LSRHokie/DIY-Flow-Bench/README.md

# NOTE: (Further information to be filled out later)   Project used knowledge and experience gained from Dee-Emm's DIY-Flow-Bench.    Project being developed for personal use with significant enough differences that i removed the fork from the original project.

[Link to the orignal DeeEmm project:](https://github.com/DeeEmm/DIY-Flow-Bench/)
