LSRHokie/DIY-Flow-Bench/hardware/kicad/flowbench-main/placement-preview.png

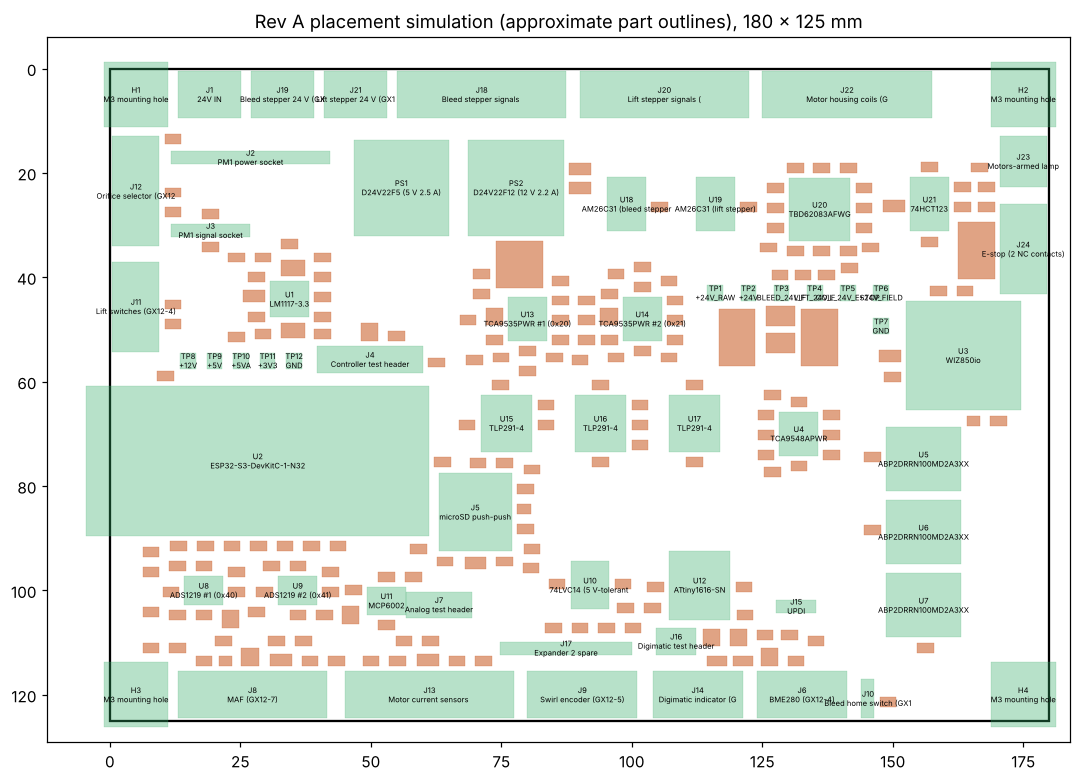
hardware/kicad/flowbench-main/placement-preview.png
