LSRHokie/DIY-Flow-Bench/docs/V2/bom.csv

Group | Qty | Part | Ref | What it does | Package | Status
Controller and network | 1 | ESP32-S3-DevKitC-1-N32R8V | U1 | Controller. 32 MB octal flash, 8 MB PSRAM, on-board antenna. Plugs into female headers. The current N32R16V (16 MB PSRAM) is a drop-in alternative. | Dev board | Decided
Controller and network | 2 | 2 × 22-pin female header, 2.54 mm | U1 | Sockets for the DevKit, rows 25.4 mm (1.0 in) apart (footprint FlowBench:ESP32-S3-DevKitC-1). | Through-hole | Decided
Controller and network | 1 | WIZnet WIZ850io | U2 | W5500 Ethernet module with RJ45 jack and magnetics on board. Alone on the SPI bus, polled (its interrupt can be jumpered to expander 2 P06). Primary network link; Wi-Fi is the fallback. Plugs in, so it moves to a new board revision. | Module | Decided
Controller and network | 2 | 1 × 6-pin female header, 2.54 mm | U2 | Sockets for the WIZ850io J1 and J2, rows 17.78 mm (0.7 in) apart (footprint FlowBench:WIZ850io). | Through-hole | Decided
Controller and network | 1 | Push-push microSD socket | J2 | Test logs and calibration files. On its own SD host bus in 1-bit mode (CLK, CMD, DAT0), not shared with the W5500. Card detect on expander 1. Pull-ups on CMD and DAT0–DAT3, 33 Ω on CLK. | SMD | Decided
Power | 1 | TI TPS26631PWP | PM1-U1 | Input eFuse on the plug-in power module: OVP 31.8 V, current limit 6.0 A, latch-off (jumper for auto-retry), inrush limit. Reverse polarity blocked by external FETs PM1-Q1/Q2. Fault and current-monitor outputs to the main board. Protects against the 48 V supply on the same XT90. | HTSSOP-20, thermal pad | Decided
Power | 1 | N-MOSFET, >=80 V, DPAK | PM1-Q1 | Reverse-polarity blocking FET driven by the eFuse B_GATE pin. Rds(on) <= 15 mOhm at 10 V (TI example CSD19537Q3). | TO-252 | Decided
Power | 1 | BSS138 | PM1-Q2 | Pulls the blocking FET gate down during reverse polarity (eFuse DRV pin). | SOT-23 | Decided
Power | 1 | Input power module (plug-in board) | PM1 | Small board carrying the TPS2663 eFuse, input TVS, bulk capacitors and the TPS7A4901 analog regulator, so the two thermal-pad parts can be replaced or moved to a new main board. Plugs in on 2.54 mm headers: 24 V in, protected 24 V out and ground on 4 pins each (about 3 A per pin); 12 V in, analog 5 V out, analog ground and eFuse fault on single pins. Made in the same PCB order. | Plug-in PCB | Decided
Power | 1 | SMCJ51CA TVS | PM1-D1 | Bidirectional input clamp ahead of the eFuse. 51 V stand-off, so a 48 V supply plugged in by mistake leaves it off and the eFuse OVP disconnects the board. | SMC | Decided
Power | 2 | Header pair for the power module | PM1 | Male headers on the module, female on the main board. Pin count set at schematic. | Through-hole | Decided
Power | 1 | Pololu D24V22F5 | PS1 | 5 V, 2.5 A switching regulator for the DevKit and logic. | Through-hole module | Decided
Power | 1 | Pololu D24V22F12 | PS2 | 12 V, 2.2 A switching regulator for the MAF and the analog rail. | Through-hole module | Decided
Power | 1 | TI TPS7A4901 | PM1-U2 | Low-noise analog 5 V from the 12 V rail, on the plug-in power module: ADC reference, MAF 5 V reference, temperature bias, harness ID. | MSOP-8, thermal pad | Decided
Power | 1 | TI LM1117-3.3 | U5 | 3.3 V, 1 A for the WIZ850io (about 130 mA), sensors, logic and Digimatic interface. | SOT-223 | Decided
Power | 3 | High-side 24 V switch (P-MOSFET + driver) | Q1–Q3 | Firmware-switched 24 V for each iCL42 (fault reset), and the watchdog-gated coil supply. Part chosen at schematic. | SMD | Decided
Power | 2 | Resettable fuse (PTC) | F1–F2 | Per-stepper 24 V protection. Rating set at schematic. | SMD | Decided
Sensing and measurement | 3 | Honeywell ABP2DRRN100MD2A3XX | U6–U8 | Pressure sensors for reference, orifice and pitot. ±100 mbar (±40 inH2O), I2C 0x28, 3.3 V, dual radial barbed ports. Confirm the overpressure rating and stock. | DIP | Decided
Sensing and measurement | 2 | TI ADS1219 | U9–U10 | 24-bit ADCs. #1 (0x40): MAF signal, intake air temperature, 5 V and 24 V checks. #2 (0x41, main bus): MAF harness ID, input current from the eFuse, two spare inputs. | TSSOP-16 | Decided
Sensing and measurement | 1 | TI TCA9548A | U11 | I2C multiplexer: three ABP2 sensors, the BME280 cable and ADC #2 each on their own channel. | TSSOP-24 | Decided
Sensing and measurement | 1 | Microchip ATtiny1616 | U12 | Digimatic interface: reads the lift indicator and answers on I2C 0x30. Firmware in firmware/digimatic-interface (capture method from KK4HFJ/mitutoyo-arduino). Programmed through a UPDI header. | SOIC-20 | Decided
Sensing and measurement | 1 | Microchip MCP6002 | U13 | Buffers the 1.65 V bias for the six motor-current inputs. | SOIC-8 | Decided
Sensing and measurement | 1 | 74LVC14 | U14 | Schmitt-trigger buffers for MAF frequency and the swirl encoder. | SOIC-14 | Decided
Sensing and measurement | — | Input protection | D1… | Series resistor plus BAV99-class clamps or TVS on every field input. Count set at schematic. | SOT-23 | Decided
I/O, drivers and safety logic | 2 | TI TCA9535 | U15–U16 | I/O expanders (0x20, 0x21): contactor coils, stepper enable and power, stepper alarms, switch inputs, eFuse fault. 8 spare pins on #2. | TSSOP-24 | Decided
I/O, drivers and safety logic | 2 | TI AM26C31 | U17–U18 | Differential line drivers for step, direction and enable to each iCL42-08. | SOIC-16 | Decided
I/O, drivers and safety logic | 1 | Toshiba TBD62083AFWG | U19 | 8-channel sink driver: six contactor coils, motors-armed lamp, one spare. | SOP-18 | Decided
I/O, drivers and safety logic | 3 | Toshiba TLP291-4 | U20–U22 | Optocouplers, 12 channels: E-stop status, both stepper alarms (iCL42-08 alarm is a normally open collector; opto LED fed from 5 V through 470 Ω), bleed home, lift home and max travel, three orifice bits, spares. | SOP-16 | Decided
I/O, drivers and safety logic | 1 | 74HCT123 | U23 | Hardware heartbeat watchdog, 5 V with TTL inputs so the 3.3 V heartbeat triggers it reliably. Drops the coil supply about 0.2 s after the firmware stops pulsing (220 k, 2.2 uF). | SOIC-16 | Decided
I/O, drivers and safety logic | 1 | UPDI programming header | J3 | For the ATtiny1616. | Through-hole | Decided
I/O, drivers and safety logic | — | Optional Digimatic inverter stage | Q10–Q11 | Footprints for an NPN transistor and resistors on the indicator's CLK and DATA lines. Fitted only if the bench check shows the signals need level shifting; otherwise bridged. | SOT-23 | Decided
I/O, drivers and safety logic | 3 | Solder jumpers | JP1–JP3 | JP1 microSD DAT0 to GPIO3 (cut if it upsets boot). JP2 MAF frequency 5 V pull-up (open-collector MAFs). JP3 WIZ850io INT to expander 2 P06. | SMD pad | Decided
I/O, drivers and safety logic | — | Test points | TP1… | Power rails, I2C, SPI, SD bus and Digimatic lines. | Through-hole loop | Decided
Panel connectors and controls | 1 | XT90 panel-mount connector |  | 24 V input from the workbench supply. | Panel | Decided
Panel connectors and controls | 1 | TE Potter & Brumfield W28-XQ1A-7 |  | 7 A, 32 V DC push-to-reset breaker. Check the tripped button is easy to see; Jaycar SF2297 is the fallback. | Panel | Decided
Panel connectors and controls | 1 | RJ45 panel bulkhead |  | Ethernet through the enclosure wall. | Panel | Decided
Panel connectors and controls | 1 | E-stop, mushroom head, 2 NC contacts |  | One contact carries the coil supply, the other reports status. | Panel | Decided
Panel connectors and controls | 1 | 24 V indicator lamp |  | Motors armed. | Panel | Decided
Panel connectors and controls | 1 | GX12 7-pin |  | MAF: 12 V, ground, analog signal (0–5 V), frequency signal, intake air temperature, 5 V reference, harness ID. Separate analog and frequency pins; the harness uses the one that matches the MAF. | Panel + plug | Decided
Panel connectors and controls | 3 | GX12 4-pin |  | BME280; lift indicator (Digimatic); lift actuator home and max-travel switches. | Panel + plug | Decided
Panel connectors and controls | 2 | GX12 5-pin |  | Swirl encoder; orifice selector. | Panel + plug | Decided
Panel connectors and controls | 1 | GX12 3-pin |  | Bleed valve home switch. | Panel + plug | Decided
Panel connectors and controls | 2 | GX12 2-pin |  | Switched 24 V to each iCL42-08. | Panel + plug | Decided
Panel connectors and controls | 4 | GX16 8-pin |  | Bleed and lift stepper signals (shielded); motor housing coils; motor current sensors (shielded). Buy plugs and sockets from one source. | Panel + plug | Decided
Panel connectors and controls | 6 | Barbed bulkhead fittings |  | Pressure ports: reference, orifice ±, pitot total and static, to the ABP2 ports by silicone tube. | Panel | Decided
Panel connectors and controls | 1 | Plastic or polycarbonate enclosure |  | Non-metal so the on-board Wi-Fi antenna works. Size set after PCB layout. |  | Decided
Panel connectors and controls | — | Pluggable terminal blocks |  | Board-side landing for every panel connector. Count set at schematic. | Through-hole | Decided
Field devices | 1 | Bosch 0280218335 (HFM-7-R5) |  | First MAF. Analog output, about 0–5 V. Confirm pinout and 12 V current on the prototype. Harness ID resistor 1.0 kΩ. |  | Decided
Field devices | 1 | SparkFun BME280 (Qwiic) |  | Temperature, humidity and baro at the enclosure air inlet, cable under about 1 m. | Breakout | Decided
Field devices | 2 | StepperOnline iCL42-08 |  | Integrated closed-loop NEMA 17 steppers, 0.8 Nm, 24 V: one for the bleed valve, one for valve lift. DIP SW6 off (closed loop). |  | Decided
Field devices | 1 | T8 lead screw kit, 8 mm lead |  | Lift actuator: lead screw, anti-backlash nut, 5 × 8 mm flexible coupler, support bearing, small linear rail and carriage. |  | Decided
Field devices | 1 | Mitutoyo 575-123 ID-U Digimatic indicator |  | Valve lift, 0–1 in, 0.0005 in resolution, ±0.0008 in. Any Digimatic-output indicator also works (Mahr MarCator 1086, Fowler/Sylvac Mark VI) with its maker's cable. |  | Decided
Field devices | 1 | Mitutoyo SPC cable 905338 (40 in) or 905409 (2 m) |  | Indicator data cable, plus a short adapter from its 10-pin plug to the GX12 4-pin. |  | Decided
Field devices | 3 | Limit switches |  | Bleed valve home, lift actuator home, lift actuator max travel. |  | Decided
Field devices | 1 | Bleed valve mechanism |  | Valve driven by the bleed iCL42-08. Designed with the bench plumbing. |  | Later
Field devices | 1 | Paddle-wheel swirl meter with quadrature encoder |  | Swirl speed and direction. |  | Later
Field devices | — | Calibrated orifice plates |  | Sourced later as known calibrated plates; selected by the 3-bit orifice selector. |  | Later
Field devices | 1 | Waveshare 12 in+ touch monitor and Raspberry Pi |  | Touch display showing the bench web page full-screen. Model being chosen. |  | Later
Vacuum motor housing (240 V) | 6 | Ametek Lamb 122165-00 |  | 240 V single-stage bypass vacuum motors, about 145 CFM each at a 28 inH2O test, up to 7.8 A each. |  | Decided
Vacuum motor housing (240 V) | 6 | Schneider TeSys D LC1D18BD |  | DIN-rail contactors, 18 A, 24 V DC coil (about 0.23 A) with built-in suppression. One per motor. | DIN rail | Decided
Vacuum motor housing (240 V) | 6 | YHDC SCT-013-010 |  | Clip-on current transformers, 10 A to 1 V. One on each motor's supply lead. |  | Decided
Vacuum motor housing (240 V) | 1 | 60 A, 240 V NEMA inlet and cord |  | Single supply connection for the housing. Your electrician chooses the exact parts. |  | Decided
Vacuum motor housing (240 V) | 6 | Per-motor branch protection |  | Breaker or fuse for each motor circuit, sized by your electrician. | DIN rail | Decided
Vacuum motor housing (240 V) | 1 | Main disconnect |  | Isolates the whole housing for service. |  | Decided
