LSRHokie/DIY-Flow-Bench/hardware/kicad/flowbench-main/controller.kicad_sch

## KiCad design hardware/kicad/flowbench-main/controller.kicad_sch (2026-10-29)

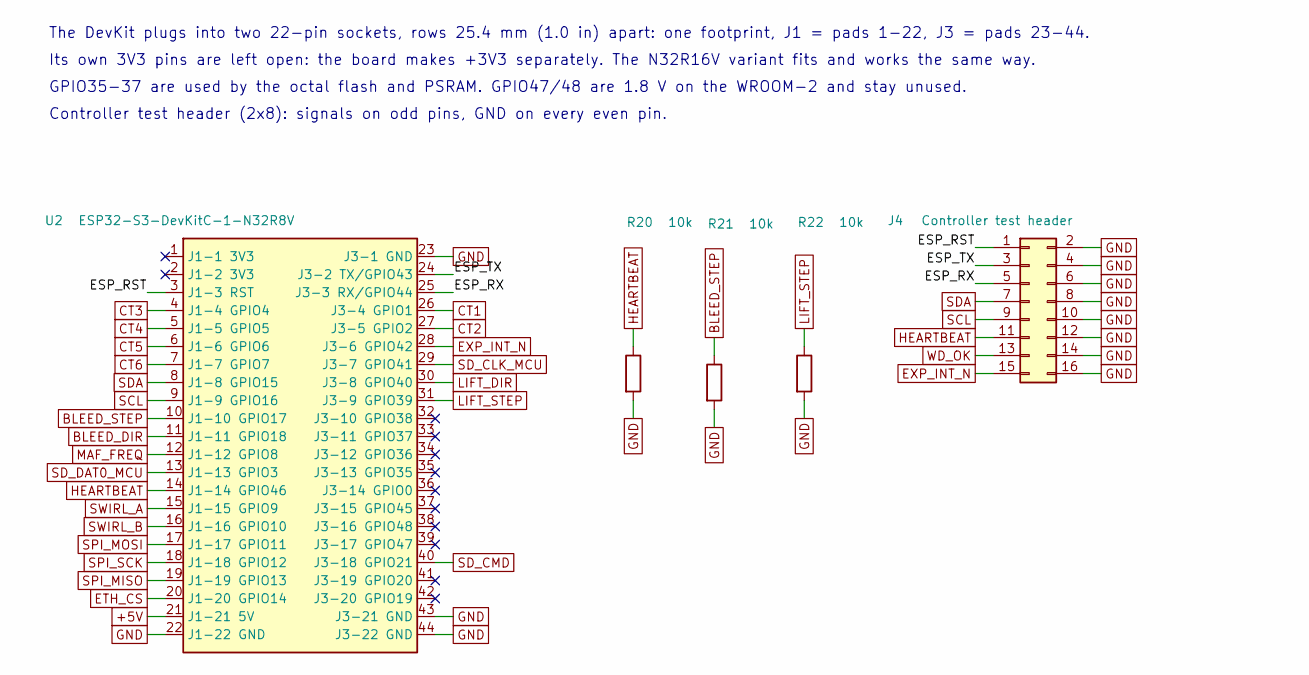
[picture p2: schematic controller.kicad_sch]

Parts:
J4: Controller test header; PinHeader_2x08_P2.54mm_Vertical
R20, R21, R22: 10k; R_0805_2012Metric
U2: ESP32-S3-DevKitC-1-N32R8V; ESP32-S3-DevKitC-1

Connections:
+5V: U2.21 (J1-21 5V)
BLEED_DIR: U2.11 (J1-11 GPIO18)
BLEED_STEP: R21.1, U2.10 (J1-10 GPIO17)
CT1: U2.26 (J3-4 GPIO1)
CT2: U2.27 (J3-5 GPIO2)
CT3: U2.4 (J1-4 GPIO4)
CT4: U2.5 (J1-5 GPIO5)
CT5: U2.6 (J1-6 GPIO6)
CT6: U2.7 (J1-7 GPIO7)
ESP_RST: J4.1, U2.3 (J1-3 RST)
ESP_RX: J4.5, U2.25 (J3-3 RX/GPIO44)
ESP_TX: J4.3, U2.24 (J3-2 TX/GPIO43)
ETH_CS: U2.20 (J1-20 GPIO14)
EXP_INT_N: J4.15, U2.28 (J3-6 GPIO42)
GND: J4.2, J4.4, J4.6, J4.8, J4.10, J4.12, J4.14, J4.16, R20.2, R21.2, R22.2, U2.22 (J1-22 GND), U2.23 (J3-1 GND), U2.43 (J3-21 GND), U2.44 (J3-22 GND)
HEARTBEAT: J4.11, R20.1, U2.14 (J1-14 GPIO46)
LIFT_DIR: U2.30 (J3-8 GPIO40)
LIFT_STEP: R22.1, U2.31 (J3-9 GPIO39)
MAF_FREQ: U2.12 (J1-12 GPIO8)
SCL: J4.9, U2.9 (J1-9 GPIO16)
SDA: J4.7, U2.8 (J1-8 GPIO15)
SD_CLK_MCU: U2.29 (J3-7 GPIO41)
SD_CMD: U2.40 (J3-18 GPIO21)
SD_DAT0_MCU: U2.13 (J1-13 GPIO3)
SPI_MISO: U2.19 (J1-19 GPIO13)
SPI_MOSI: U2.17 (J1-17 GPIO11)
SPI_SCK: U2.18 (J1-18 GPIO12)
SWIRL_A: U2.15 (J1-15 GPIO9)
SWIRL_B: U2.16 (J1-16 GPIO10)
WD_OK: J4.13

Notes on the sheet:
The DevKit plugs into two 22-pin sockets, rows 25.4 mm (1.0 in) apart: one footprint, J1 = pads 1-22, J3 = pads 23-44.
Its own 3V3 pins are left open: the board makes +3V3 separately. The N32R16V variant fits and works the same way.
GPIO35-37 are used by the octal flash and PSRAM. GPIO47/48 are 1.8 V on the WROOM-2 and stay unused.
Controller test header (2x8): signals on odd pins, GND on every even pin.
