LSRHokie/DIY-Flow-Bench/hardware/kicad/flowbench-main/field.kicad_sch

## KiCad design hardware/kicad/flowbench-main/field.kicad_sch (2026-10-29)

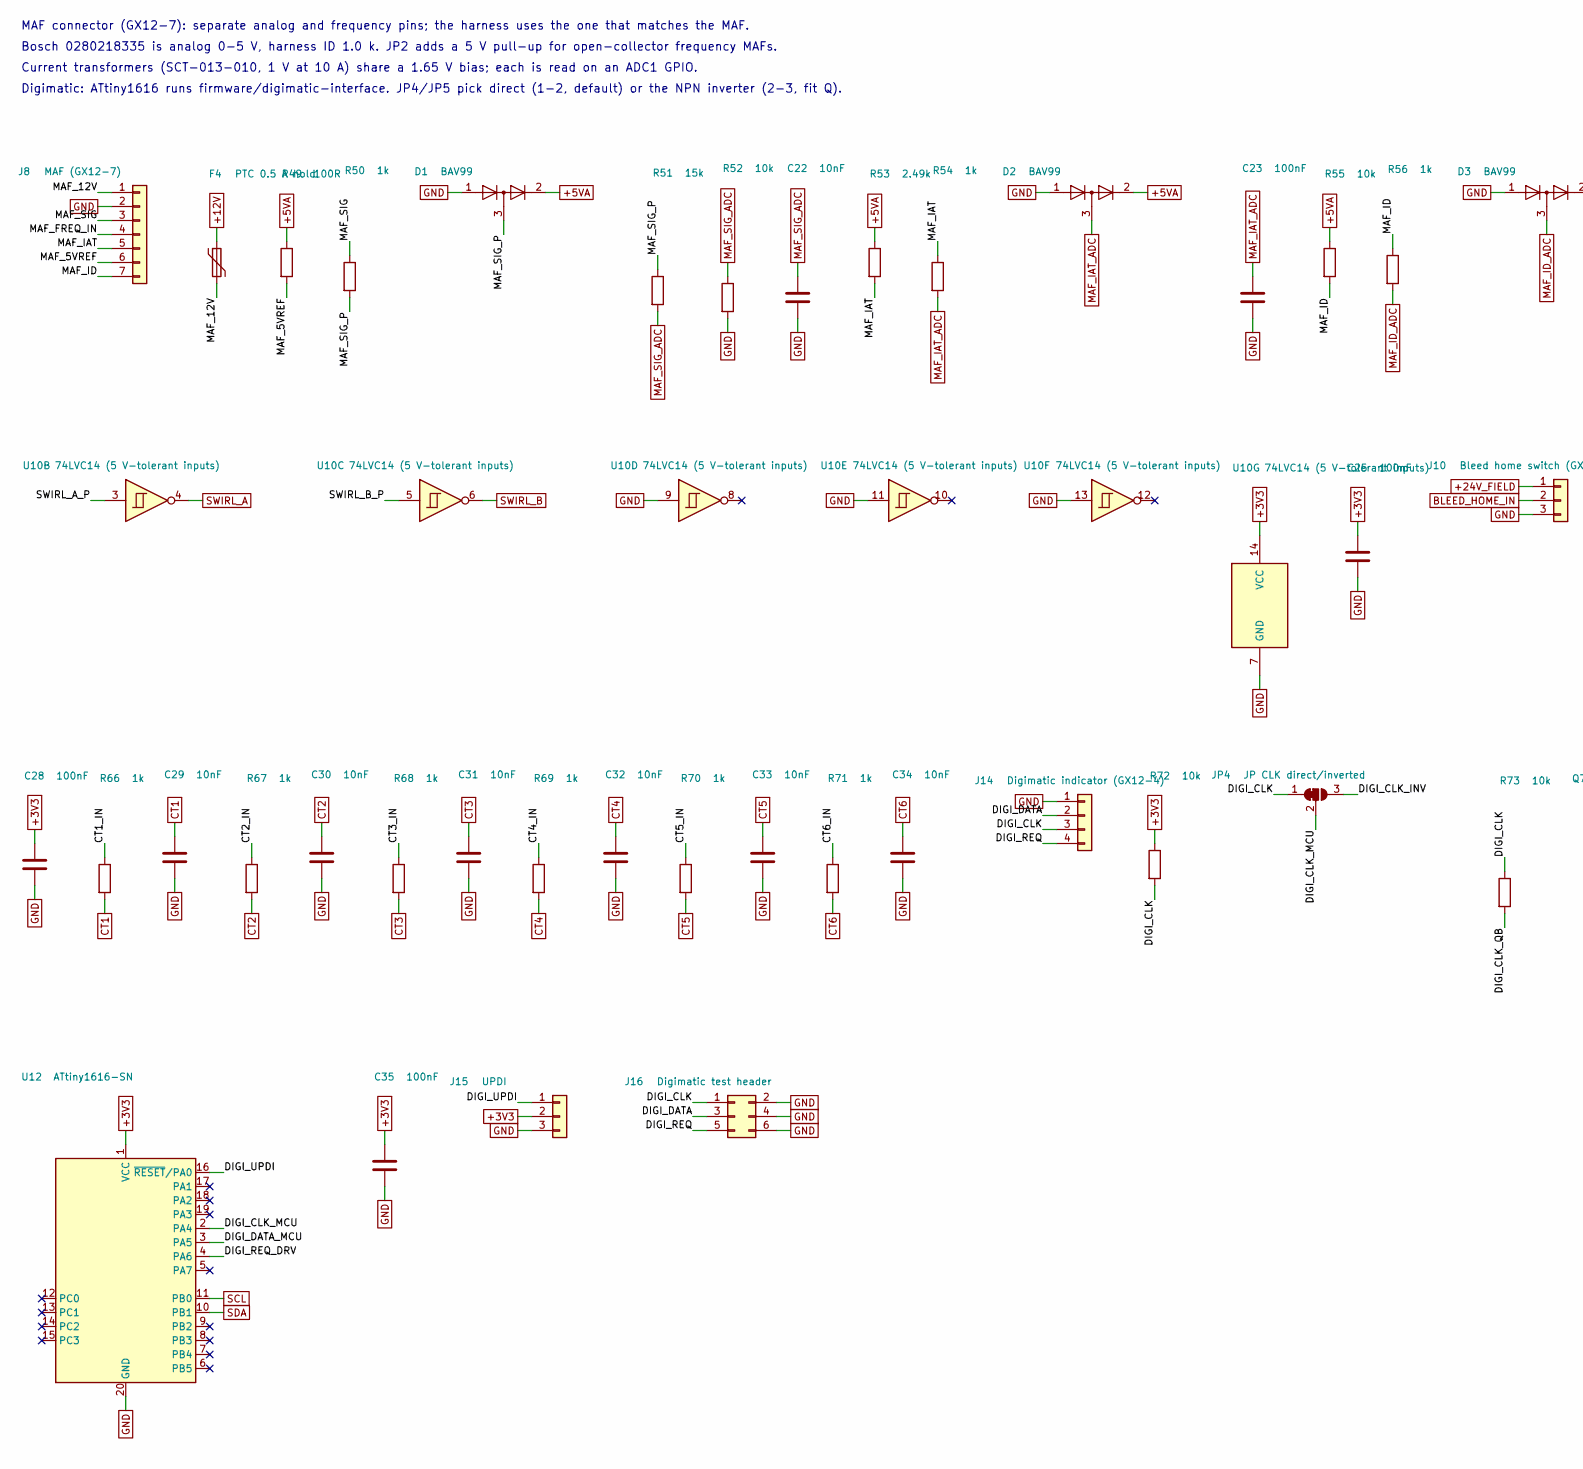
[picture p3: schematic field.kicad_sch, part in row 1, column 1]

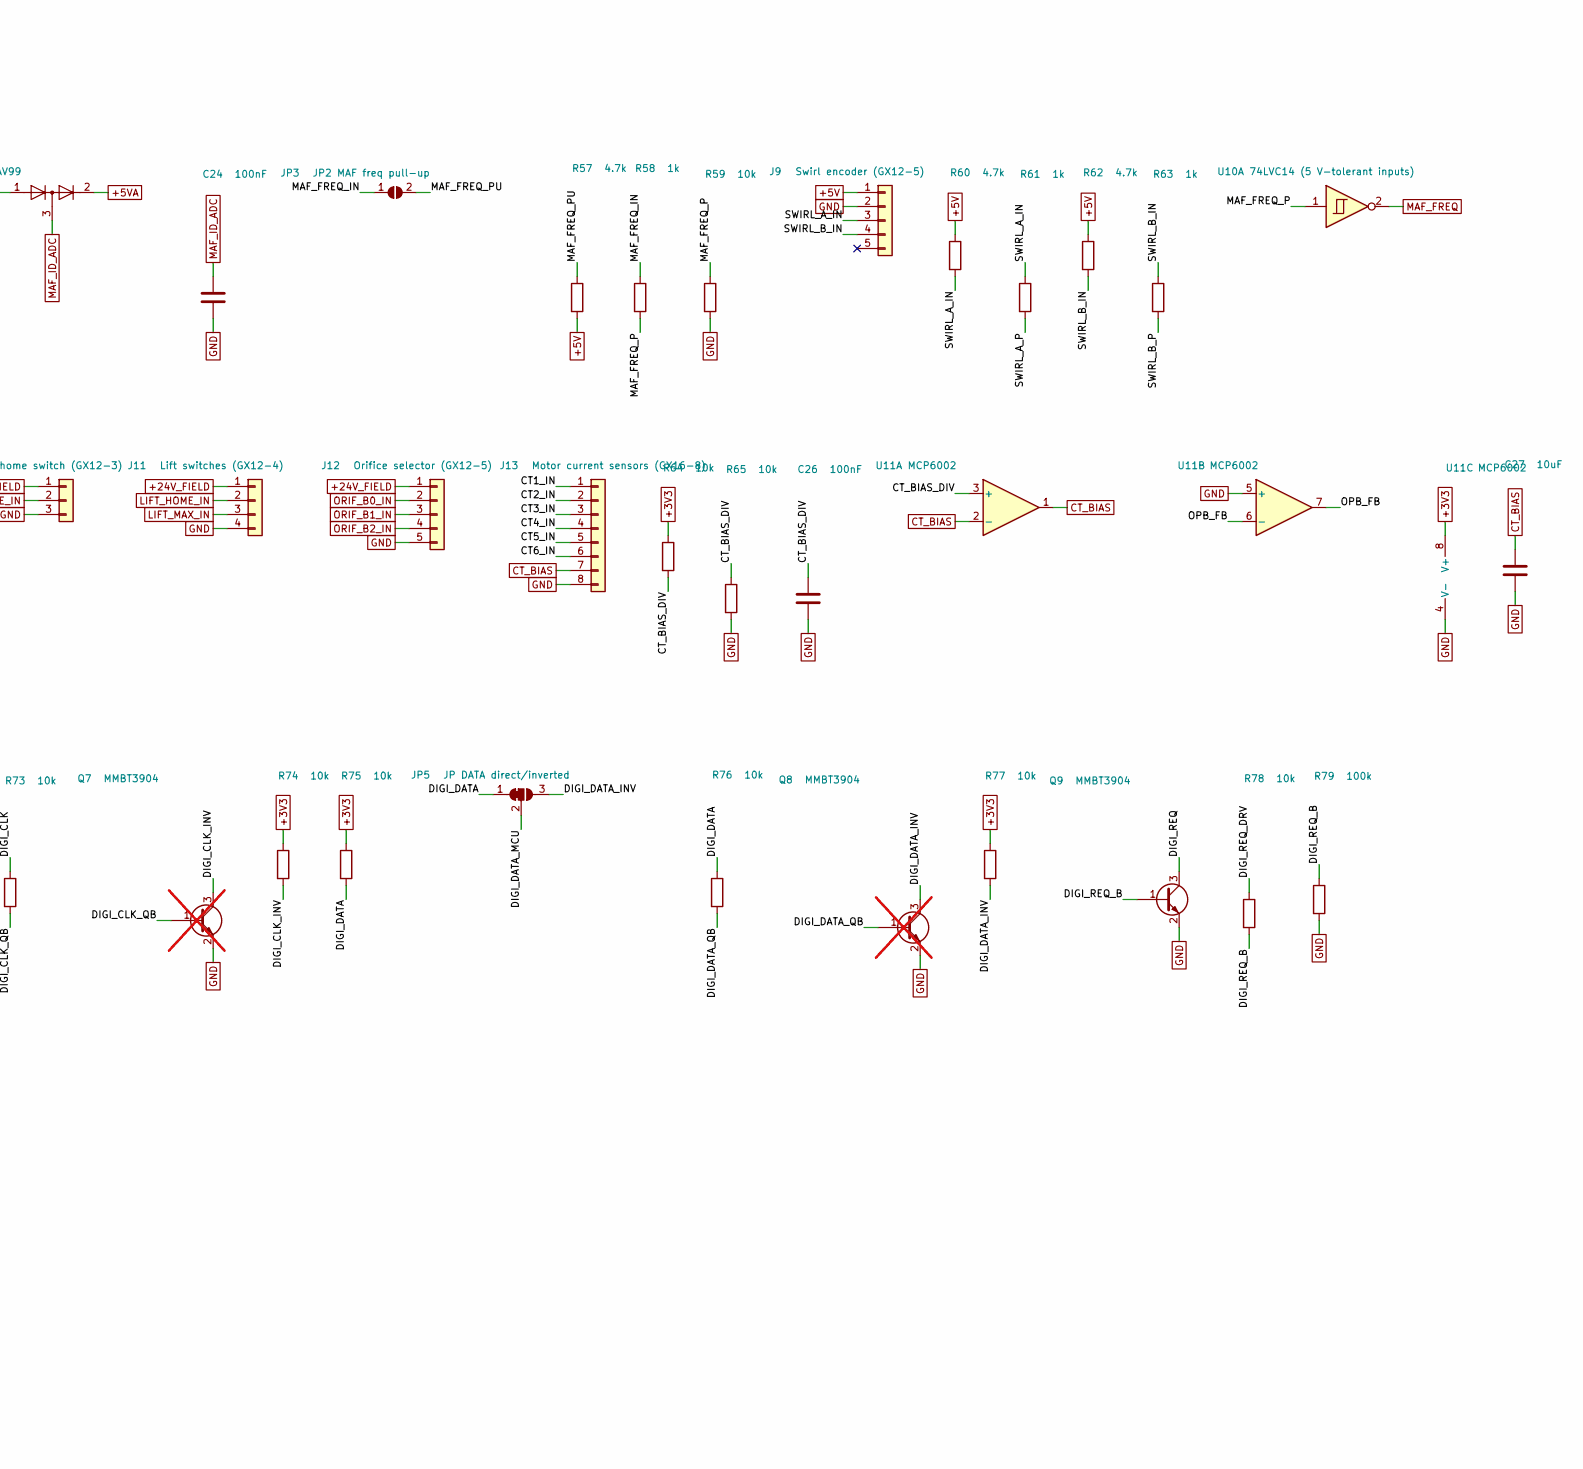
[picture p4: schematic field.kicad_sch, part in row 1, column 2]

Parts:
C22, C29, C30, C31, C32, C33, C34: 10nF; C_0805_2012Metric
C23, C24, C25, C26, C28, C35: 100nF; C_0805_2012Metric
C27: 10uF; C_1206_3216Metric
D1, D2, D3: BAV99; SOT-23
F4: PTC 0.5 A hold; Fuse_1206_3216Metric
J8: MAF (GX12-7); PhoenixContact_MC_1,5_7-G-3.81_1x07_P3.81mm_Horizontal
J9: Swirl encoder (GX12-5); PhoenixContact_MC_1,5_5-G-3.81_1x05_P3.81mm_Horizontal
J10: Bleed home switch (GX12-3); PhoenixContact_MC_1,5_3-G-3.81_1x03_P3.81mm_Horizontal
J11: Lift switches (GX12-4); PhoenixContact_MC_1,5_4-G-3.81_1x04_P3.81mm_Horizontal
J12: Orifice selector (GX12-5); PhoenixContact_MC_1,5_5-G-3.81_1x05_P3.81mm_Horizontal
J13: Motor current sensors (GX16-8); PhoenixContact_MC_1,5_8-G-3.81_1x08_P3.81mm_Horizontal
J14: Digimatic indicator (GX12-4); PhoenixContact_MC_1,5_4-G-3.81_1x04_P3.81mm_Horizontal
J15: UPDI; PinHeader_1x03_P2.54mm_Vertical
J16: Digimatic test header; PinHeader_2x03_P2.54mm_Vertical
JP3: JP2 MAF freq pull-up; SolderJumper-2_P1.3mm_Open_RoundedPad1.0x1.5mm
JP4: JP CLK direct/inverted; SolderJumper-3_P1.3mm_Bridged12_RoundedPad1.0x1.5mm
JP5: JP DATA direct/inverted; SolderJumper-3_P1.3mm_Bridged12_RoundedPad1.0x1.5mm
Q7, Q8: MMBT3904; SOT-23; not fitted
Q9: MMBT3904; SOT-23
R49: 100R; R_0805_2012Metric
R50, R54, R56, R58, R61, R63, R66, R67, R68, R69, R70, R71: 1k; R_0805_2012Metric
R51: 15k; R_0805_2012Metric
R52, R55, R59, R64, R65, R72, R73, R74, R75, R76, R77, R78: 10k; R_0805_2012Metric
R53: 2.49k; R_0805_2012Metric
R57, R60, R62: 4.7k; R_0805_2012Metric
R79: 100k; R_0805_2012Metric
U10: 74LVC14 (5 V-tolerant inputs); SOIC-14_3.9x8.7mm_P1.27mm
U11: MCP6002; SOIC-8_3.9x4.9mm_P1.27mm
U12: ATtiny1616-SN; SOIC-20W_7.5x12.8mm_P1.27mm

Connections:
+3V3: C25.1, C28.1, C35.1, J15.2, R64.1, R72.1, R74.1, R75.1, R77.1, U10.14 (VCC), U11.8 (V+), U12.1 (VCC)
+5V: J9.1, R57.2, R60.1, R62.1
+5VA: D1.2 (A), D2.2 (A), D3.2 (A), R49.1, R53.1, R55.1
+12V: F4.1
+24V_FIELD: J10.1, J11.1, J12.1
BLEED_HOME_IN: J10.2
CT1: C29.1, R66.2
CT1_IN: J13.1, R66.1
CT2: C30.1, R67.2
CT2_IN: J13.2, R67.1
CT3: C31.1, R68.2
CT3_IN: J13.3, R68.1
CT4: C32.1, R69.2
CT4_IN: J13.4, R69.1
CT5: C33.1, R70.2
CT5_IN: J13.5, R70.1
CT6: C34.1, R71.2
CT6_IN: J13.6, R71.1
CT_BIAS: C27.1, J13.7, U11.1, U11.2 (-)
CT_BIAS_DIV: C26.1, R64.2, R65.1, U11.3 (+)
DIGI_CLK: J14.3, J16.1, JP4.1 (A), R72.2, R73.1
DIGI_CLK_INV: JP4.3 (B), Q7.3 (C), R74.2
DIGI_CLK_MCU: JP4.2 (C), U12.2 (PA4)
DIGI_CLK_QB: Q7.1 (B), R73.2
DIGI_DATA: J14.2, J16.3, JP5.1 (A), R75.2, R76.1
DIGI_DATA_INV: JP5.3 (B), Q8.3 (C), R77.2
DIGI_DATA_MCU: JP5.2 (C), U12.3 (PA5)
DIGI_DATA_QB: Q8.1 (B), R76.2
DIGI_REQ: J14.4, J16.5, Q9.3 (C)
DIGI_REQ_B: Q9.1 (B), R78.2, R79.1
DIGI_REQ_DRV: R78.1, U12.4 (PA6)
DIGI_UPDI: J15.1, U12.16 (~RESET/PA0)
GND: C22.2, C23.2, C24.2, C25.2, C26.2, C27.2, C28.2, C29.2, C30.2, C31.2, C32.2, C33.2, C34.2, C35.2, D1.1 (K), D2.1 (K), D3.1 (K), J8.2, J9.2, J10.3, J11.4, J12.5, J13.8, J14.1, J15.3, J16.2, J16.4, J16.6, Q7.2 (E), Q8.2 (E), Q9.2 (E), R52.2, R59.2, R65.2, R79.2, U10.7 (GND), U10.9, U10.11, U10.13, U11.4 (V-), U11.5 (+), U12.20 (GND)
LIFT_HOME_IN: J11.2
LIFT_MAX_IN: J11.3
MAF_5VREF: J8.6, R49.2
MAF_12V: F4.2, J8.1
MAF_FREQ: U10.2
MAF_FREQ_IN: J8.4, JP3.1 (A), R58.1
MAF_FREQ_P: R58.2, R59.1, U10.1
MAF_FREQ_PU: JP3.2 (B), R57.1
MAF_IAT: J8.5, R53.2, R54.1
MAF_IAT_ADC: C23.1, D2.3 (K), R54.2
MAF_ID: J8.7, R55.2, R56.1
MAF_ID_ADC: C24.1, D3.3 (K), R56.2
MAF_SIG: J8.3, R50.1
MAF_SIG_ADC: C22.1, R51.2, R52.1
MAF_SIG_P: D1.3 (K), R50.2, R51.1
OPB_FB: U11.6 (-), U11.7
ORIF_B0_IN: J12.2
ORIF_B1_IN: J12.3
ORIF_B2_IN: J12.4
SCL: U12.11 (PB0)
SDA: U12.10 (PB1)
SWIRL_A: U10.4
SWIRL_A_IN: J9.3, R60.2, R61.1
SWIRL_A_P: R61.2, U10.3
SWIRL_B: U10.6
SWIRL_B_IN: J9.4, R62.2, R63.1
SWIRL_B_P: R63.2, U10.5

Notes on the sheet:
MAF connector (GX12-7): separate analog and frequency pins; the harness uses the one that matches the MAF.
Bosch 0280218335 is analog 0-5 V, harness ID 1.0 k. JP2 adds a 5 V pull-up for open-collector frequency MAFs.
Current transformers (SCT-013-010, 1 V at 10 A) share a 1.65 V bias; each is read on an ADC1 GPIO.
Digimatic: ATtiny1616 runs firmware/digimatic-interface. JP4/JP5 pick direct (1-2, default) or the NPN inverter (2-3, fit Q).
