LSRHokie/DIY-Flow-Bench/hardware/kicad/flowbench-main/io.kicad_sch

## KiCad design hardware/kicad/flowbench-main/io.kicad_sch (2026-10-28)

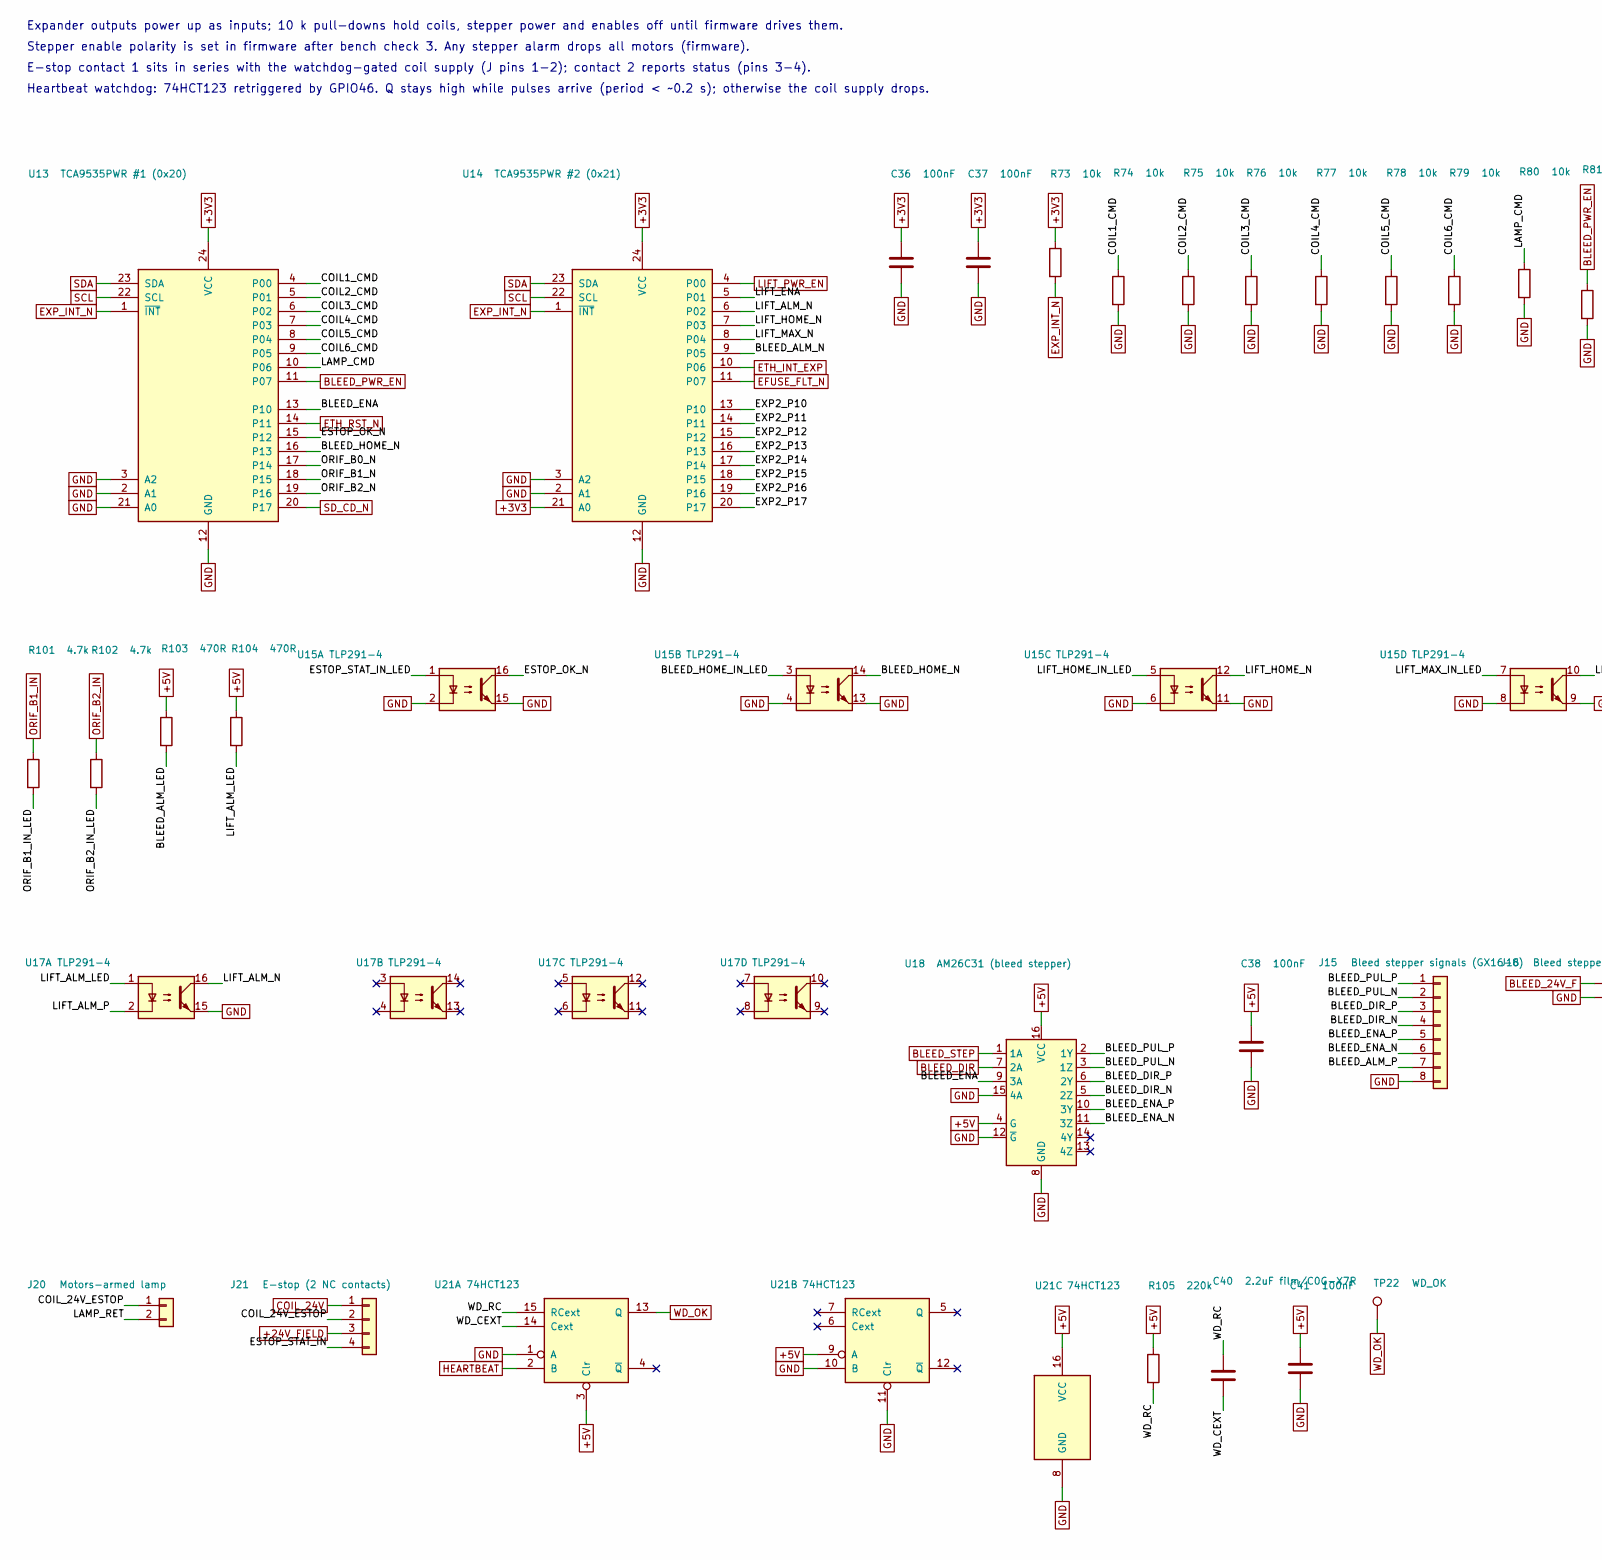
[picture p5: schematic io.kicad_sch, part in row 1, column 1]

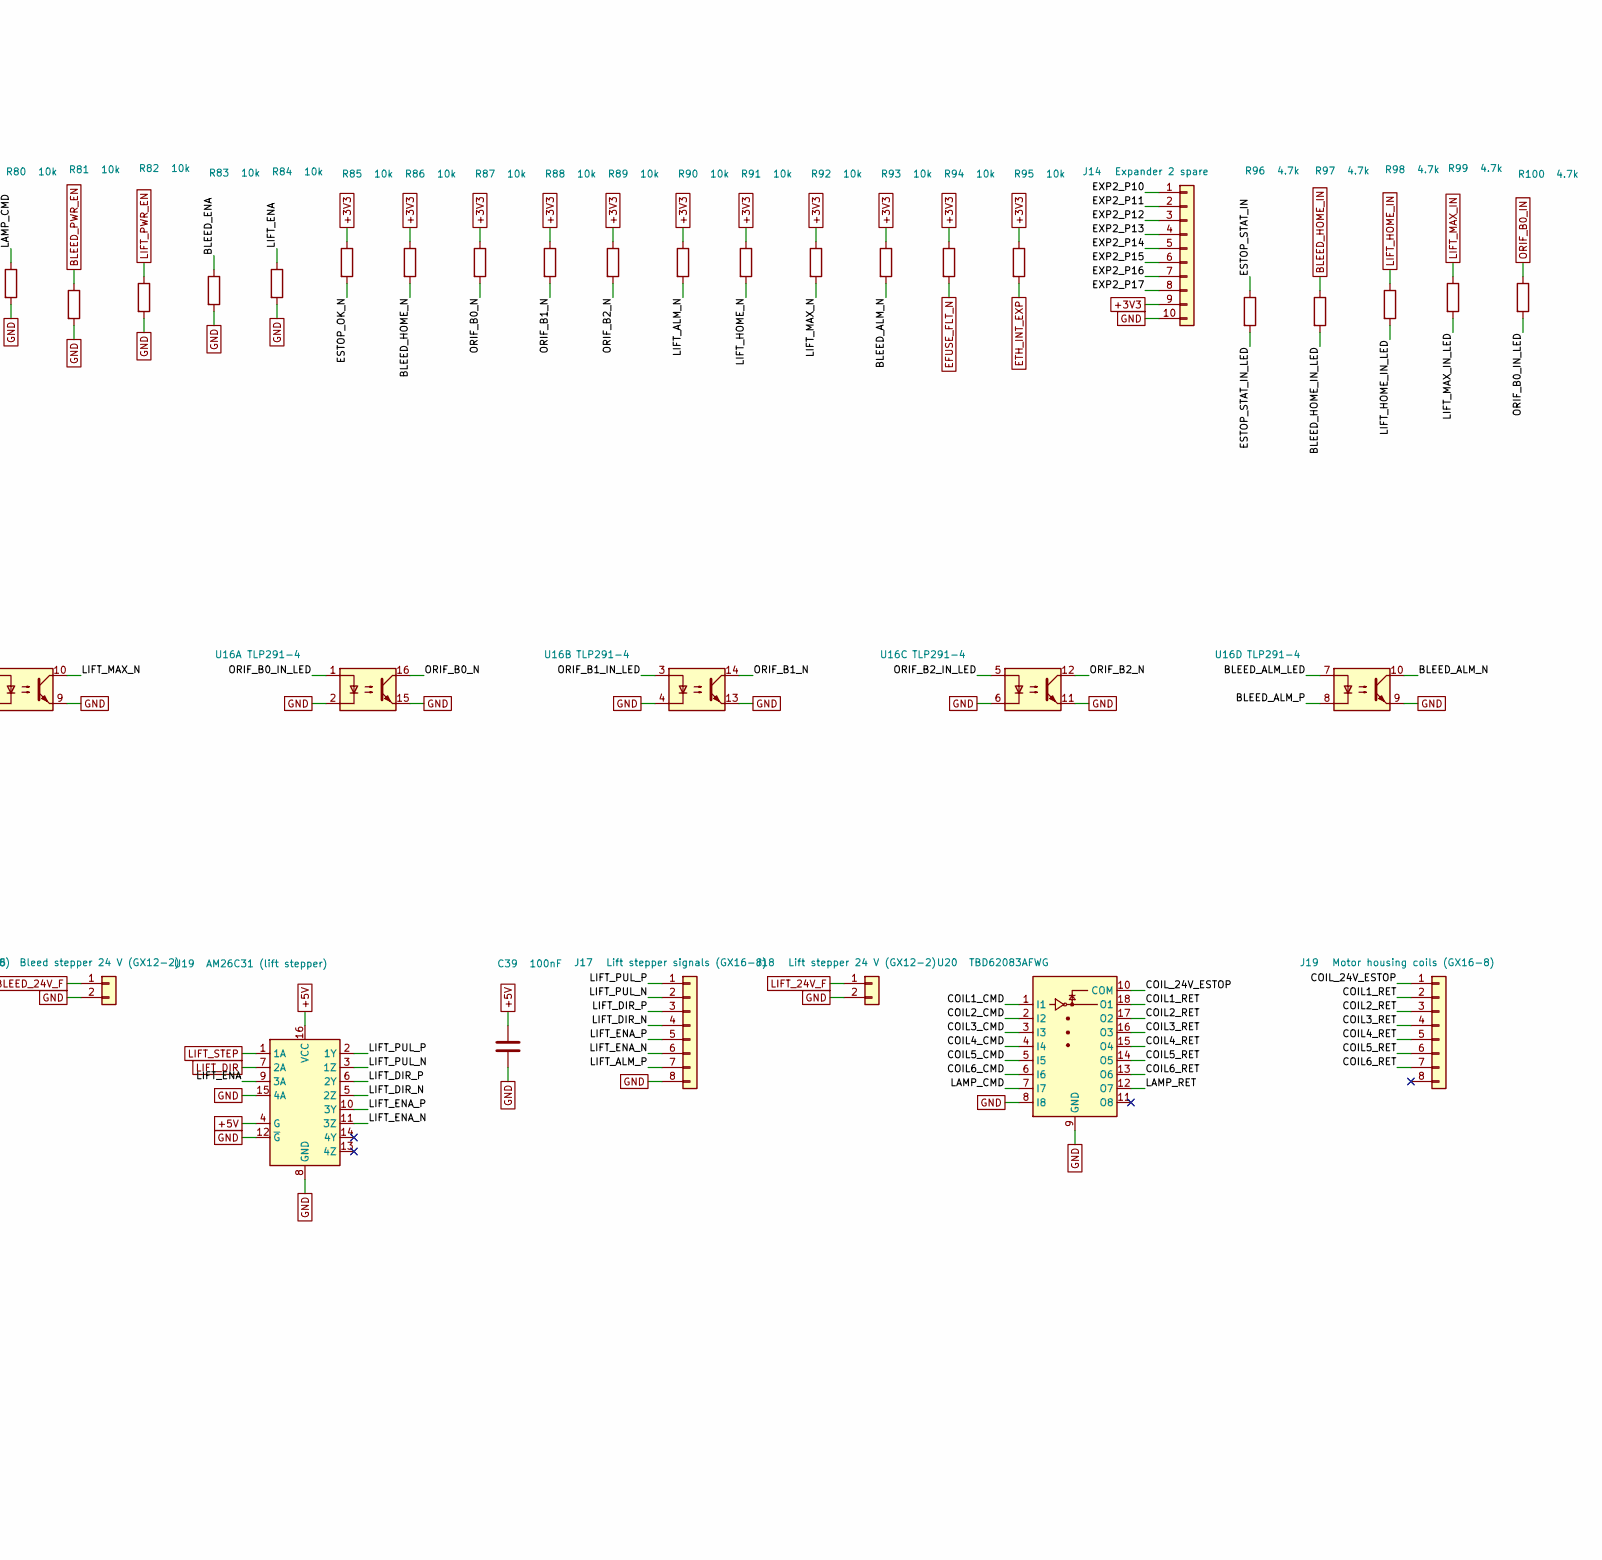
[picture p6: schematic io.kicad_sch, part in row 1, column 2]

Parts:
C36, C37, C38, C39, C41: 100nF; C_0805_2012Metric
C40: 2.2uF film/C0G-X7R; C_1206_3216Metric
J14: Expander 2 spare; PinHeader_1x10_P2.54mm_Vertical
J15: Bleed stepper signals (GX16-8); PhoenixContact_MC_1,5_8-G-3.81_1x08_P3.81mm_Horizontal
J16: Bleed stepper 24 V (GX12-2); PhoenixContact_MSTBA_2,5_2-G-5,08_1x02_P5.08mm_Horizontal
J17: Lift stepper signals (GX16-8); PhoenixContact_MC_1,5_8-G-3.81_1x08_P3.81mm_Horizontal
J18: Lift stepper 24 V (GX12-2); PhoenixContact_MSTBA_2,5_2-G-5,08_1x02_P5.08mm_Horizontal
J19: Motor housing coils (GX16-8); PhoenixContact_MC_1,5_8-G-3.81_1x08_P3.81mm_Horizontal
J20: Motors-armed lamp; PhoenixContact_MC_1,5_2-G-3.81_1x02_P3.81mm_Horizontal
J21: E-stop (2 NC contacts); PhoenixContact_MC_1,5_4-G-3.81_1x04_P3.81mm_Horizontal
R73, R74, R75, R76, R77, R78, R79, R80, R81, R82, R83, R84, R85, R86, R87, R88, R89, R90, R91, R92, R93, R94, R95: 10k; R_0805_2012Metric
R96, R97, R98, R99, R100, R101, R102: 4.7k; R_0805_2012Metric
R103, R104: 470R; R_0805_2012Metric
R105: 220k; R_0805_2012Metric
TP22: WD_OK; TestPoint_Loop_D2.50mm_Drill1.0mm
U13: TCA9535PWR #1 (0x20); TSSOP-24_4.4x7.8mm_P0.65mm
U14: TCA9535PWR #2 (0x21); TSSOP-24_4.4x7.8mm_P0.65mm
U15, U16, U17: TLP291-4; SOIC-16_4.55x10.3mm_P1.27mm
U18: AM26C31 (bleed stepper); SOIC-16_3.9x9.9mm_P1.27mm
U19: AM26C31 (lift stepper); SOIC-16_3.9x9.9mm_P1.27mm
U20: TBD62083AFWG; SOIC-18W_7.5x11.6mm_P1.27mm
U21: 74HCT123; SOIC-16_3.9x9.9mm_P1.27mm

Connections:
+3V3: C36.1, C37.1, J14.9, R73.1, R85.1, R86.1, R87.1, R88.1, R89.1, R90.1, R91.1, R92.1, R93.1, R94.1, R95.1, U13.24 (VCC), U14.21 (A0), U14.24 (VCC)
+5V: C38.1, C39.1, C41.1, R103.1, R104.1, R105.1, U18.4 (G), U18.16 (VCC), U19.4 (G), U19.16 (VCC), U21.3 (Clr), U21.9 (A), U21.16 (VCC)
+24V_FIELD: J21.3
BLEED_24V_F: J16.1
BLEED_ALM_LED: R103.2, U16.7
BLEED_ALM_N: R93.2, U14.9 (P05), U16.10
BLEED_ALM_P: J15.7, U16.8
BLEED_DIR: U18.7 (2A)
BLEED_DIR_N: J15.4, U18.5 (2Z)
BLEED_DIR_P: J15.3, U18.6 (2Y)
BLEED_ENA: R83.1, U13.13 (P10), U18.9 (3A)
BLEED_ENA_N: J15.6, U18.11 (3Z)
BLEED_ENA_P: J15.5, U18.10 (3Y)
BLEED_HOME_IN: R97.1
BLEED_HOME_IN_LED: R97.2, U15.3
BLEED_HOME_N: R86.2, U13.16 (P13), U15.14
BLEED_PUL_N: J15.2, U18.3 (1Z)
BLEED_PUL_P: J15.1, U18.2 (1Y)
BLEED_PWR_EN: R81.1, U13.11 (P07)
BLEED_STEP: U18.1 (1A)
COIL1_CMD: R74.1, U13.4 (P00), U20.1 (I1)
COIL1_RET: J19.2, U20.18 (O1)
COIL2_CMD: R75.1, U13.5 (P01), U20.2 (I2)
COIL2_RET: J19.3, U20.17 (O2)
COIL3_CMD: R76.1, U13.6 (P02), U20.3 (I3)
COIL3_RET: J19.4, U20.16 (O3)
COIL4_CMD: R77.1, U13.7 (P03), U20.4 (I4)
COIL4_RET: J19.5, U20.15 (O4)
COIL5_CMD: R78.1, U13.8 (P04), U20.5 (I5)
COIL5_RET: J19.6, U20.14 (O5)
COIL6_CMD: R79.1, U13.9 (P05), U20.6 (I6)
COIL6_RET: J19.7, U20.13 (O6)
COIL_24V: J21.1
COIL_24V_ESTOP: J19.1, J20.1, J21.2, U20.10 (COM)
EFUSE_FLT_N: R94.2, U14.11 (P07)
ESTOP_OK_N: R85.2, U13.15 (P12), U15.16
ESTOP_STAT_IN: J21.4, R96.1
ESTOP_STAT_IN_LED: R96.2, U15.1
ETH_INT_EXP: R95.2, U14.10 (P06)
ETH_RST_N: U13.14 (P11)
EXP2_P10: J14.1, U14.13 (P10)
EXP2_P11: J14.2, U14.14 (P11)
EXP2_P12: J14.3, U14.15 (P12)
EXP2_P13: J14.4, U14.16 (P13)
EXP2_P14: J14.5, U14.17 (P14)
EXP2_P15: J14.6, U14.18 (P15)
EXP2_P16: J14.7, U14.19 (P16)
EXP2_P17: J14.8, U14.20 (P17)
EXP_INT_N: R73.2, U13.1 (~INT), U14.1 (~INT)
GND: C36.2, C37.2, C38.2, C39.2, C41.2, J14.10, J15.8, J16.2, J17.8, J18.2, R74.2, R75.2, R76.2, R77.2, R78.2, R79.2, R80.2, R81.2, R82.2, R83.2, R84.2, U13.2 (A1), U13.3 (A2), U13.12 (GND), U13.21 (A0), U14.2 (A1), U14.3 (A2), U14.12 (GND), U15.2, U15.4, U15.6, U15.8, U15.9, U15.11, U15.13, U15.15, U16.2, U16.4, U16.6, U16.9, U16.11, U16.13, U16.15, U17.15, U18.8 (GND), U18.12 (~G), U18.15 (4A), U19.8 (GND), U19.12 (~G), U19.15 (4A), U20.8 (I8), U20.9 (GND), U21.1 (A), U21.8 (GND), U21.10 (B), U21.11 (Clr)
HEARTBEAT: U21.2 (B)
LAMP_CMD: R80.1, U13.10 (P06), U20.7 (I7)
LAMP_RET: J20.2, U20.12 (O7)
LIFT_24V_F: J18.1
LIFT_ALM_LED: R104.2, U17.1
LIFT_ALM_N: R90.2, U14.6 (P02), U17.16
LIFT_ALM_P: J17.7, U17.2
LIFT_DIR: U19.7 (2A)
LIFT_DIR_N: J17.4, U19.5 (2Z)
LIFT_DIR_P: J17.3, U19.6 (2Y)
LIFT_ENA: R84.1, U14.5 (P01), U19.9 (3A)
LIFT_ENA_N: J17.6, U19.11 (3Z)
LIFT_ENA_P: J17.5, U19.10 (3Y)
LIFT_HOME_IN: R98.1
LIFT_HOME_IN_LED: R98.2, U15.5
LIFT_HOME_N: R91.2, U14.7 (P03), U15.12
LIFT_MAX_IN: R99.1
LIFT_MAX_IN_LED: R99.2, U15.7
LIFT_MAX_N: R92.2, U14.8 (P04), U15.10
LIFT_PUL_N: J17.2, U19.3 (1Z)
LIFT_PUL_P: J17.1, U19.2 (1Y)
LIFT_PWR_EN: R82.1, U14.4 (P00)
LIFT_STEP: U19.1 (1A)
ORIF_B0_IN: R100.1
ORIF_B0_IN_LED: R100.2, U16.1
ORIF_B0_N: R87.2, U13.17 (P14), U16.16
ORIF_B1_IN: R101.1
ORIF_B1_IN_LED: R101.2, U16.3
ORIF_B1_N: R88.2, U13.18 (P15), U16.14
ORIF_B2_IN: R102.1
ORIF_B2_IN_LED: R102.2, U16.5
ORIF_B2_N: R89.2, U13.19 (P16), U16.12
SCL: U13.22 (SCL), U14.22 (SCL)
SDA: U13.23 (SDA), U14.23 (SDA)
SD_CD_N: U13.20 (P17)
WD_CEXT: C40.2, U21.14 (Cext)
WD_OK: TP22.1, U21.13 (Q)
WD_RC: C40.1, R105.2, U21.15 (RCext)

Notes on the sheet:
Expander outputs power up as inputs; 10 k pull-downs hold coils, stepper power and enables off until firmware drives them.
Stepper enable polarity is set in firmware after bench check 3. Any stepper alarm drops all motors (firmware).
E-stop contact 1 sits in series with the watchdog-gated coil supply (J pins 1-2); contact 2 reports status (pins 3-4).
Heartbeat watchdog: 74HCT123 retriggered by GPIO46. Q stays high while pulses arrive (period < ~0.2 s); otherwise the coil supply drops.
