LSRHokie/DIY-Flow-Bench/hardware/kicad/flowbench-main/network.kicad_sch

## KiCad design hardware/kicad/flowbench-main/network.kicad_sch (2026-10-28)

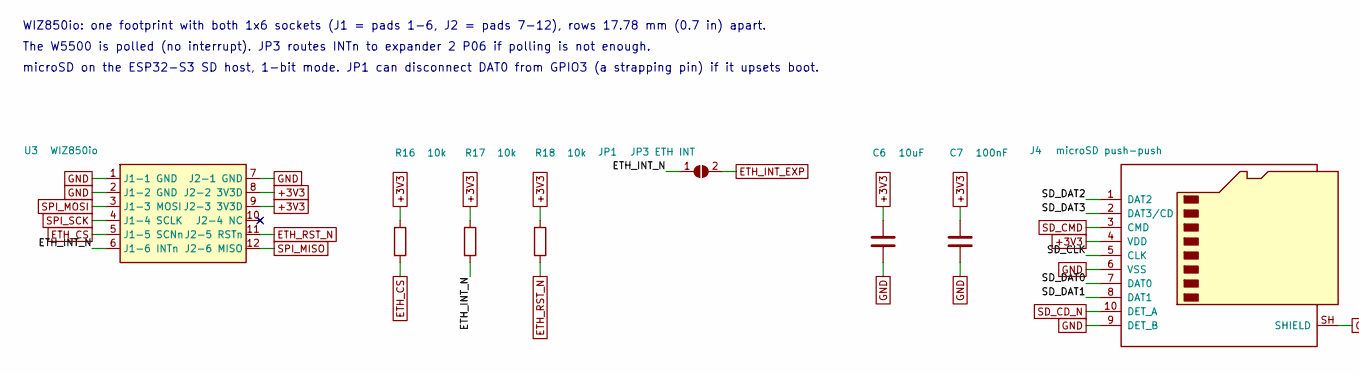
[picture p7: schematic network.kicad_sch, part in row 1, column 1]

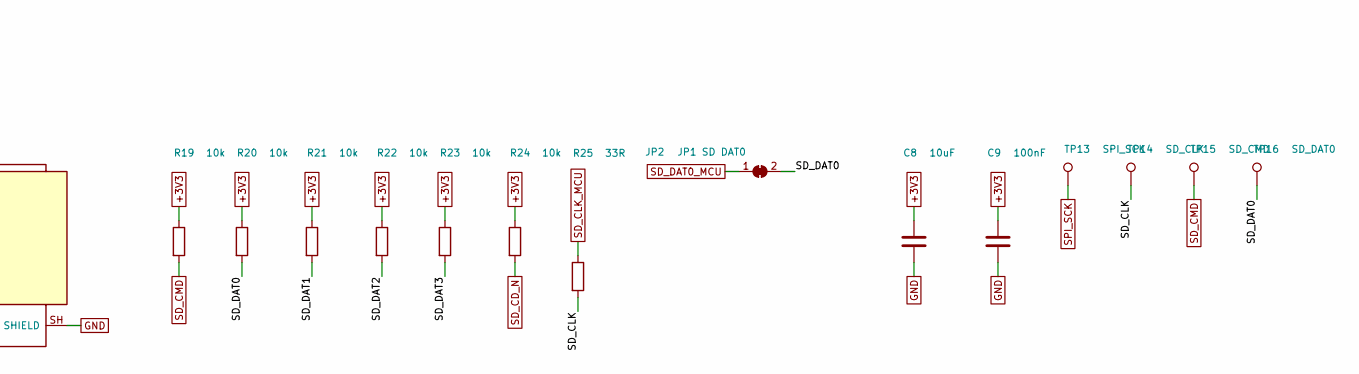
[picture p8: schematic network.kicad_sch, part in row 1, column 2]

Parts:
C6, C8: 10uF; C_1206_3216Metric
C7, C9: 100nF; C_0805_2012Metric
J4: microSD push-push; microSD_HC_Hirose_DM3AT-SF-PEJM5
JP1: JP3 ETH INT; SolderJumper-2_P1.3mm_Open_RoundedPad1.0x1.5mm
JP2: JP1 SD DAT0; SolderJumper-2_P1.3mm_Bridged_RoundedPad1.0x1.5mm
R16, R17, R18, R19, R20, R21, R22, R23, R24: 10k; R_0805_2012Metric
R25: 33R; R_0805_2012Metric
TP13: SPI_SCK; TestPoint_Loop_D2.50mm_Drill1.0mm
TP14: SD_CLK; TestPoint_Loop_D2.50mm_Drill1.0mm
TP15: SD_CMD; TestPoint_Loop_D2.50mm_Drill1.0mm
TP16: SD_DAT0; TestPoint_Loop_D2.50mm_Drill1.0mm
U3: WIZ850io

Connections:
+3V3: C6.1, C7.1, C8.1, C9.1, J4.4 (VDD), R16.1, R17.1, R18.1, R19.1, R20.1, R21.1, R22.1, R23.1, R24.1, U3.8 (J2-2 3V3D), U3.9 (J2-3 3V3D)
ETH_CS: R16.2, U3.5 (J1-5 SCNn)
ETH_INT_EXP: JP1.2 (B)
ETH_INT_N: JP1.1 (A), R17.2, U3.6 (J1-6 INTn)
ETH_RST_N: R18.2, U3.11 (J2-5 RSTn)
GND: C6.2, C7.2, C8.2, C9.2, J4.6 (VSS), J4.9 (DET_B), J4.SH (SHIELD), U3.1 (J1-1 GND), U3.2 (J1-2 GND), U3.7 (J2-1 GND)
SD_CD_N: J4.10 (DET_A), R24.2
SD_CLK: J4.5 (CLK), R25.2, TP14.1
SD_CLK_MCU: R25.1
SD_CMD: J4.3 (CMD), R19.2, TP15.1
SD_DAT0: J4.7 (DAT0), JP2.2 (B), R20.2, TP16.1
SD_DAT0_MCU: JP2.1 (A)
SD_DAT1: J4.8 (DAT1), R21.2
SD_DAT2: J4.1 (DAT2), R22.2
SD_DAT3: J4.2 (DAT3/CD), R23.2
SPI_MISO: U3.12 (J2-6 MISO)
SPI_MOSI: U3.3 (J1-3 MOSI)
SPI_SCK: TP13.1, U3.4 (J1-4 SCLK)

Notes on the sheet:
WIZ850io: one footprint with both 1x6 sockets (J1 = pads 1-6, J2 = pads 7-12), rows 17.78 mm (0.7 in) apart.
The W5500 is polled (no interrupt). JP3 routes INTn to expander 2 P06 if polling is not enough.
microSD on the ESP32-S3 SD host, 1-bit mode. JP1 can disconnect DAT0 from GPIO3 (a strapping pin) if it upsets boot.
