LSRHokie/DIY-Flow-Bench/hardware/kicad/flowbench-main/power.kicad_sch

## KiCad design hardware/kicad/flowbench-main/power.kicad_sch (2026-10-28)

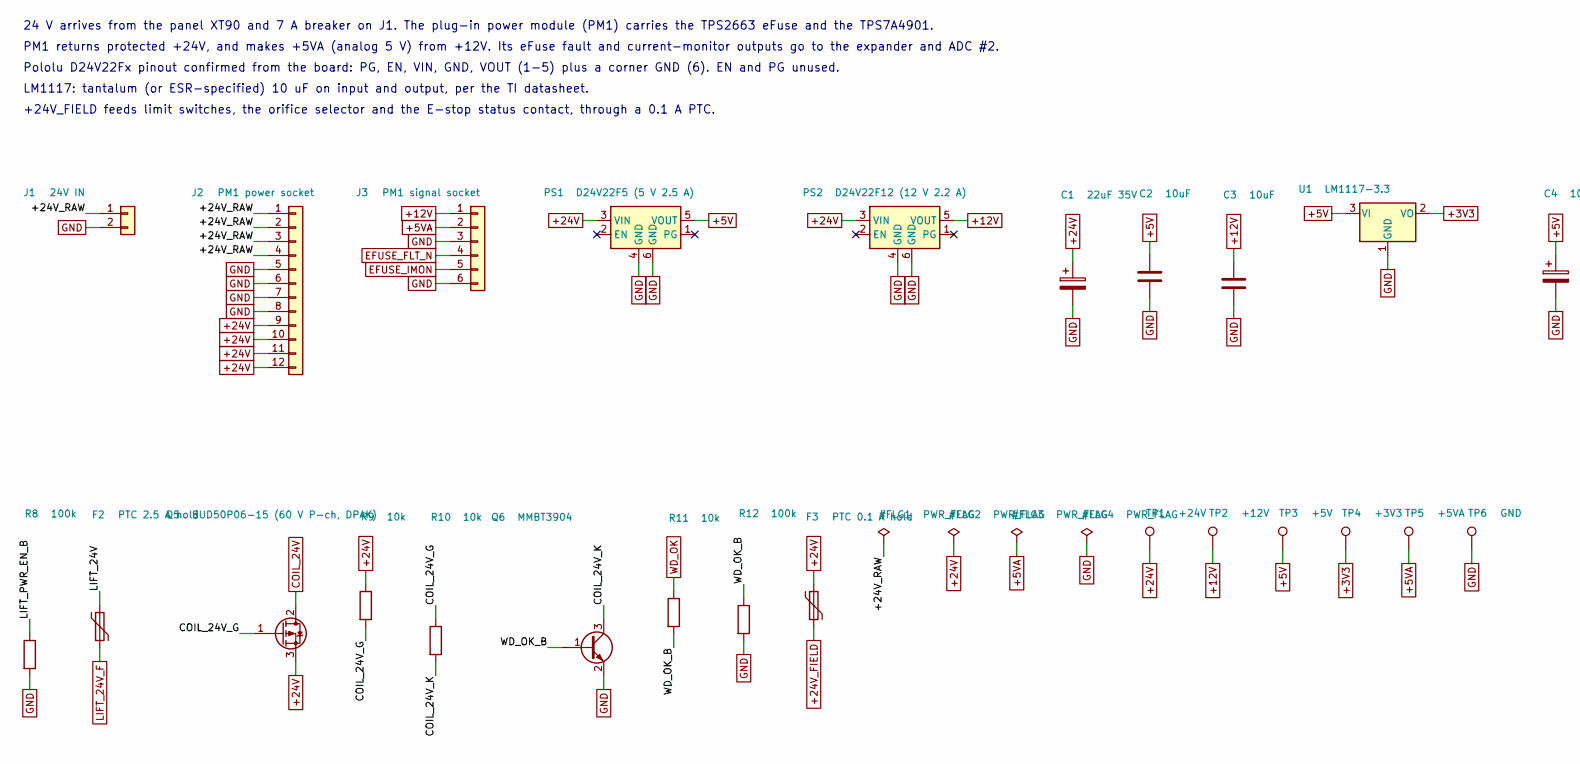
[picture p9: schematic power.kicad_sch, part in row 1, column 1]

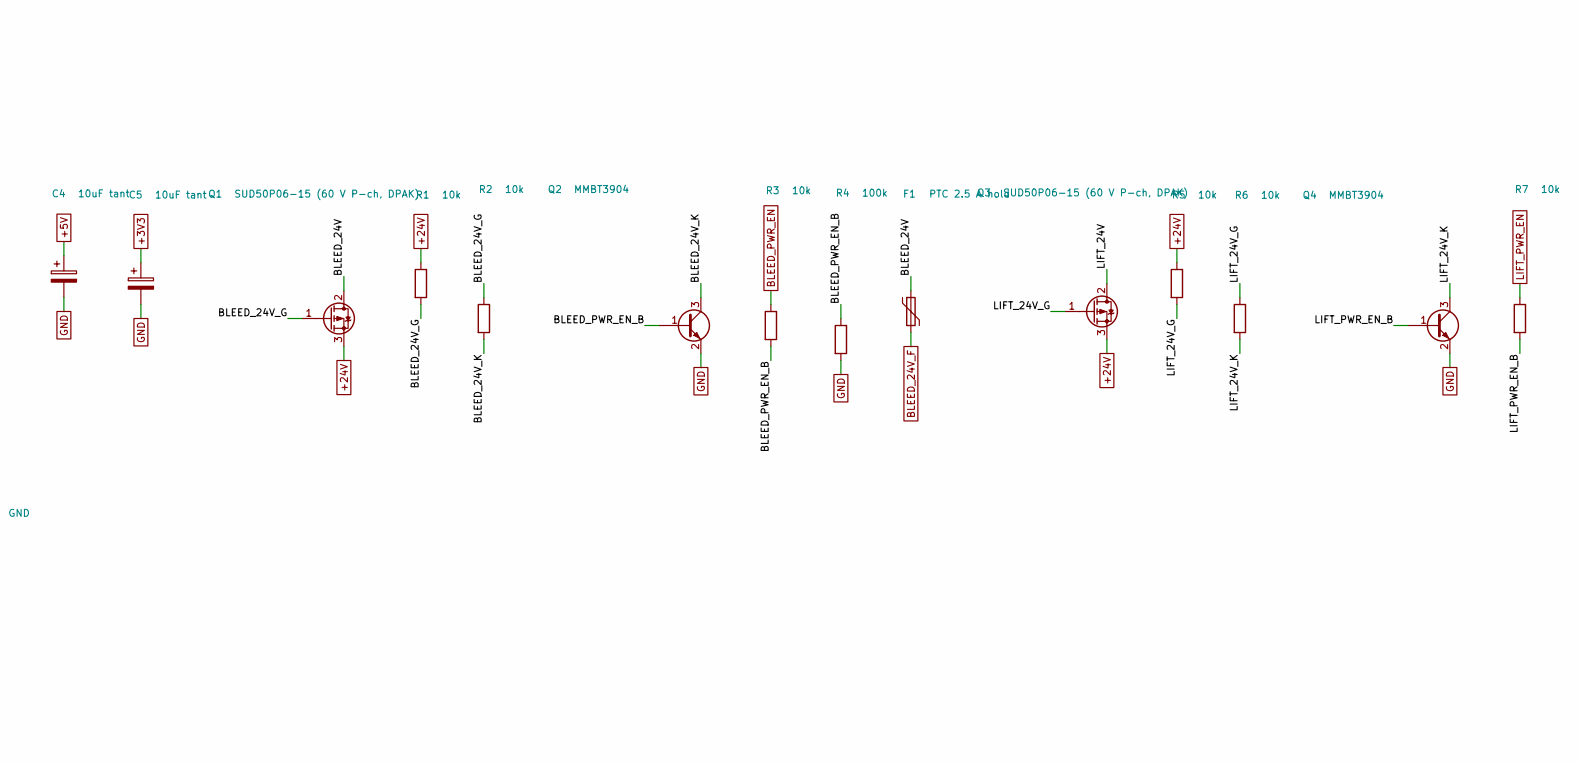
[picture p10: schematic power.kicad_sch, part in row 1, column 2]

Parts:
C1: 22uF 35V; CP_Radial_D8.0mm_P3.50mm
C2, C3: 10uF; C_1206_3216Metric
C4, C5: 10uF tant; CP_EIA-3528-21_Kemet-B
F1, F2: PTC 2.5 A hold; Fuse_1812_4532Metric
F3: PTC 0.1 A hold; Fuse_1206_3216Metric
J1: 24V IN; PhoenixContact_MSTBA_2,5_2-G-5,08_1x02_P5.08mm_Horizontal
J2: PM1 power socket; PinSocket_1x12_P2.54mm_Vertical
J3: PM1 signal socket; PinSocket_1x06_P2.54mm_Vertical
PS1: D24V22F5 (5 V 2.5 A); Pololu_D24V22Fx
PS2: D24V22F12 (12 V 2.2 A); Pololu_D24V22Fx
Q1, Q3, Q5: SUD50P06-15 (60 V P-ch, DPAK); TO-252-2
Q2, Q4, Q6: MMBT3904; SOT-23
R1, R2, R3, R5, R6, R7, R9, R10, R11: 10k; R_0805_2012Metric
R4, R8, R12: 100k; R_0805_2012Metric
TP1: +24V; TestPoint_Loop_D2.50mm_Drill1.0mm
TP2: +12V; TestPoint_Loop_D2.50mm_Drill1.0mm
TP3: +5V; TestPoint_Loop_D2.50mm_Drill1.0mm
TP4: +3V3; TestPoint_Loop_D2.50mm_Drill1.0mm
TP5: +5VA; TestPoint_Loop_D2.50mm_Drill1.0mm
TP6: GND; TestPoint_Loop_D2.50mm_Drill1.0mm
U1: LM1117-3.3; SOT-223-3_TabPin2

Connections:
+3V3: C5.1, TP4.1, U1.2 (VO)
+5V: C2.1, C4.1, PS1.5 (VOUT), TP3.1, U1.3 (VI)
+5VA: J3.2, TP5.1
+12V: C3.1, J3.1, PS2.5 (VOUT), TP2.1
+24V: C1.1, F3.1, J2.9, J2.10, J2.11, J2.12, PS1.3 (VIN), PS2.3 (VIN), Q1.3 (S), Q3.3 (S), Q5.3 (S), R1.1, R5.1, R9.1, TP1.1
+24V_FIELD: F3.2
+24V_RAW: J1.1, J2.1, J2.2, J2.3, J2.4
BLEED_24V: F1.1, Q1.2 (D)
BLEED_24V_F: F1.2
BLEED_24V_G: Q1.1 (G), R1.2, R2.1
BLEED_24V_K: Q2.3 (C), R2.2
BLEED_PWR_EN: R3.1
BLEED_PWR_EN_B: Q2.1 (B), R3.2, R4.1
COIL_24V: Q5.2 (D)
COIL_24V_G: Q5.1 (G), R9.2, R10.1
COIL_24V_K: Q6.3 (C), R10.2
EFUSE_FLT_N: J3.4
EFUSE_IMON: J3.5
GND: C1.2, C2.2, C3.2, C4.2, C5.2, J1.2, J2.5, J2.6, J2.7, J2.8, J3.3, J3.6, PS1.4 (GND), PS1.6 (GND), PS2.4 (GND), PS2.6 (GND), Q2.2 (E), Q4.2 (E), Q6.2 (E), R4.2, R8.2, R12.2, TP6.1, U1.1 (GND)
LIFT_24V: F2.1, Q3.2 (D)
LIFT_24V_F: F2.2
LIFT_24V_G: Q3.1 (G), R5.2, R6.1
LIFT_24V_K: Q4.3 (C), R6.2
LIFT_PWR_EN: R7.1
LIFT_PWR_EN_B: Q4.1 (B), R7.2, R8.1
WD_OK: R11.1
WD_OK_B: Q6.1 (B), R11.2, R12.1

Notes on the sheet:
24 V arrives from the panel XT90 and 7 A breaker on J1. The plug-in power module (PM1) carries the TPS2663 eFuse and the TPS7A4901.
PM1 returns protected +24V, and makes +5VA (analog 5 V) from +12V. Its eFuse fault and current-monitor outputs go to the expander and ADC #2.
Pololu D24V22Fx pinout confirmed from the board: PG, EN, VIN, GND, VOUT (1-5) plus a corner GND (6). EN and PG unused.
LM1117: tantalum (or ESR-specified) 10 uF on input and output, per the TI datasheet.
+24V_FIELD feeds limit switches, the orifice selector and the E-stop status contact, through a 0.1 A PTC.
