LSRHokie/DIY-Flow-Bench/hardware/kicad/flowbench-main/sensors.kicad_sch

## KiCad design hardware/kicad/flowbench-main/sensors.kicad_sch (2026-10-29)

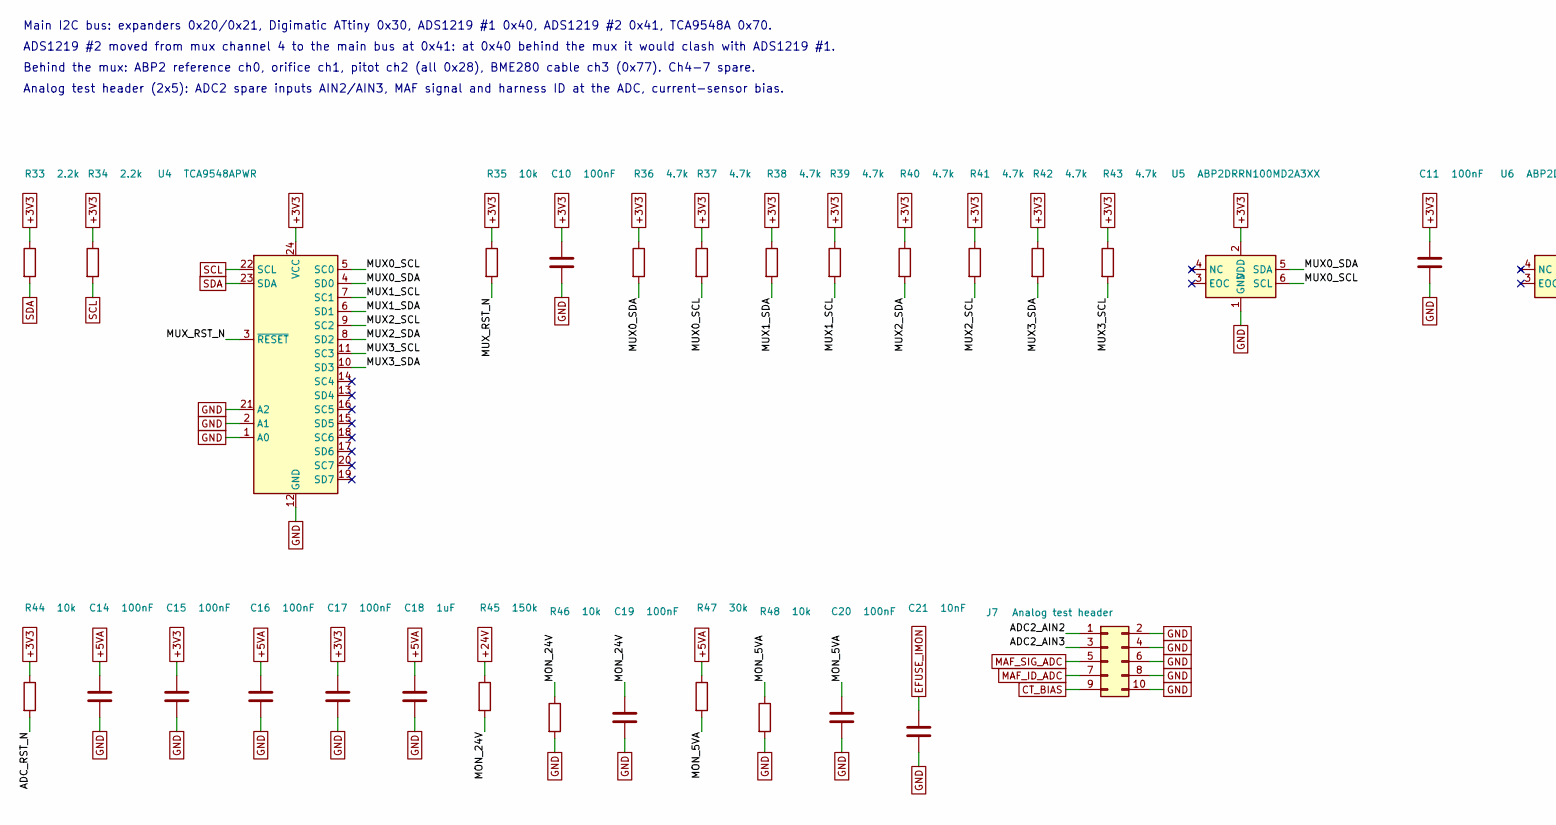
[picture p11: schematic sensors.kicad_sch, part in row 1, column 1]

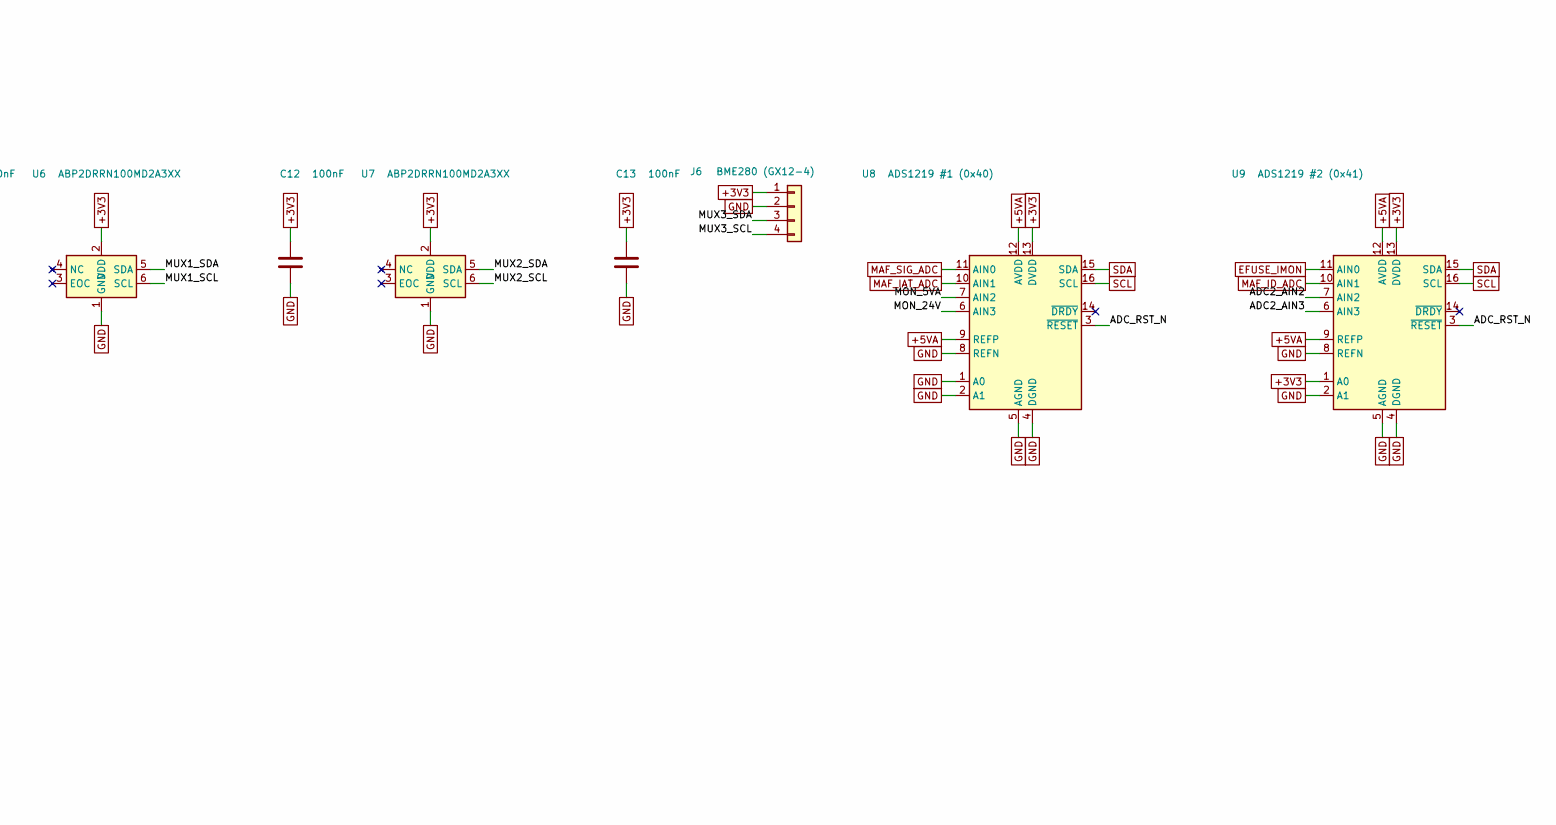
[picture p12: schematic sensors.kicad_sch, part in row 1, column 2]

Parts:
C10, C11, C12, C13, C14, C15, C16, C17, C19, C20: 100nF; C_0805_2012Metric
C18: 1uF; C_0805_2012Metric
C21: 10nF; C_0805_2012Metric
J6: BME280 (GX12-4); PhoenixContact_MC_1,5_4-G-3.81_1x04_P3.81mm_Horizontal
J7: Analog test header; PinHeader_2x05_P2.54mm_Vertical
R33, R34: 2.2k; R_0805_2012Metric
R35, R44, R46, R48: 10k; R_0805_2012Metric
R36, R37, R38, R39, R40, R41, R42, R43: 4.7k; R_0805_2012Metric
R45: 150k; R_0805_2012Metric
R47: 30k; R_0805_2012Metric
U4: TCA9548APWR; TSSOP-24_4.4x7.8mm_P0.65mm
U5, U6, U7: ABP2DRRN100MD2A3XX; Honeywell_ABP2_DIP
U8: ADS1219 #1 (0x40); TSSOP-16_4.4x5mm_P0.65mm
U9: ADS1219 #2 (0x41); TSSOP-16_4.4x5mm_P0.65mm

Connections:
+3V3: C10.1, C11.1, C12.1, C13.1, C15.1, C17.1, J6.1, R33.1, R34.1, R35.1, R36.1, R37.1, R38.1, R39.1, R40.1, R41.1, R42.1, R43.1, R44.1, U4.24 (VCC), U5.2 (VDD), U6.2 (VDD), U7.2 (VDD), U8.13 (DVDD), U9.1 (A0), U9.13 (DVDD)
+5VA: C14.1, C16.1, C18.1, R47.1, U8.9 (REFP), U8.12 (AVDD), U9.9 (REFP), U9.12 (AVDD)
+24V: R45.1
ADC2_AIN2: J7.1, U9.7 (AIN2)
ADC2_AIN3: J7.3, U9.6 (AIN3)
ADC_RST_N: R44.2, U8.3 (~RESET), U9.3 (~RESET)
CT_BIAS: J7.9
EFUSE_IMON: C21.1, U9.11 (AIN0)
GND: C10.2, C11.2, C12.2, C13.2, C14.2, C15.2, C16.2, C17.2, C18.2, C19.2, C20.2, C21.2, J6.2, J7.2, J7.4, J7.6, J7.8, J7.10, R46.2, R48.2, U4.1 (A0), U4.2 (A1), U4.12 (GND), U4.21 (A2), U5.1 (GND), U6.1 (GND), U7.1 (GND), U8.1 (A0), U8.2 (A1), U8.4 (DGND), U8.5 (AGND), U8.8 (REFN), U9.2 (A1), U9.4 (DGND), U9.5 (AGND), U9.8 (REFN)
MAF_IAT_ADC: U8.10 (AIN1)
MAF_ID_ADC: J7.7, U9.10 (AIN1)
MAF_SIG_ADC: J7.5, U8.11 (AIN0)
MON_5VA: C20.1, R47.2, R48.1, U8.7 (AIN2)
MON_24V: C19.1, R45.2, R46.1, U8.6 (AIN3)
MUX0_SCL: R37.2, U4.5 (SC0), U5.6 (SCL)
MUX0_SDA: R36.2, U4.4 (SD0), U5.5 (SDA)
MUX1_SCL: R39.2, U4.7 (SC1), U6.6 (SCL)
MUX1_SDA: R38.2, U4.6 (SD1), U6.5 (SDA)
MUX2_SCL: R41.2, U4.9 (SC2), U7.6 (SCL)
MUX2_SDA: R40.2, U4.8 (SD2), U7.5 (SDA)
MUX3_SCL: J6.4, R43.2, U4.11 (SC3)
MUX3_SDA: J6.3, R42.2, U4.10 (SD3)
MUX_RST_N: R35.2, U4.3 (~RESET)
SCL: R34.2, U4.22 (SCL), U8.16 (SCL), U9.16 (SCL)
SDA: R33.2, U4.23 (SDA), U8.15 (SDA), U9.15 (SDA)

Notes on the sheet:
Main I2C bus: expanders 0x20/0x21, Digimatic ATtiny 0x30, ADS1219 #1 0x40, ADS1219 #2 0x41, TCA9548A 0x70.
ADS1219 #2 moved from mux channel 4 to the main bus at 0x41: at 0x40 behind the mux it would clash with ADS1219 #1.
Behind the mux: ABP2 reference ch0, orifice ch1, pitot ch2 (all 0x28), BME280 cable ch3 (0x77). Ch4-7 spare.
Analog test header (2x5): ADC2 spare inputs AIN2/AIN3, MAF signal and harness ID at the ADC, current-sensor bias.
