LSRHokie/DIY-Flow-Bench/hardware/kicad/flowbench-power-module/power-module.kicad_sch

## KiCad design hardware/kicad/flowbench-power-module/power-module.kicad_sch (2026-10-28)

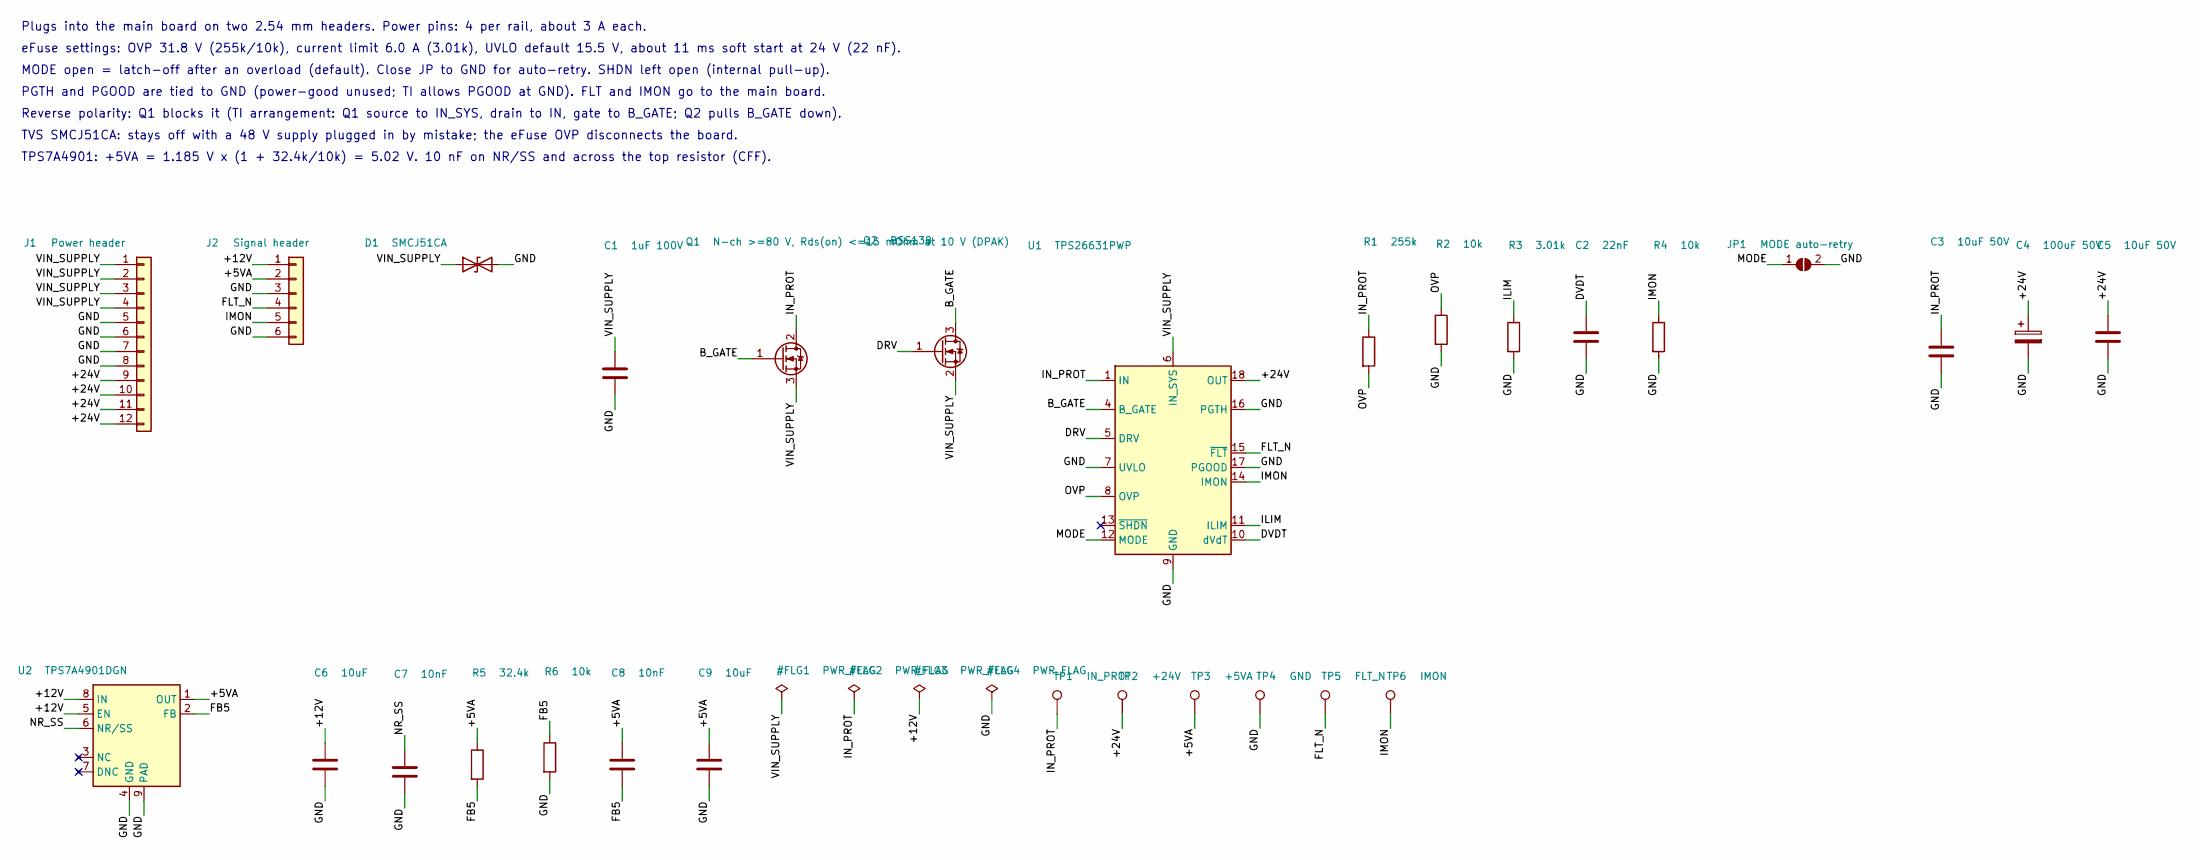
[picture p13: schematic power-module.kicad_sch]

Parts:
C1: 1uF 100V; C_1210_3225Metric
C2: 22nF; C_0805_2012Metric
C3, C5: 10uF 50V; C_1210_3225Metric
C4: 100uF 50V; CP_Radial_D8.0mm_P3.50mm
C6, C9: 10uF; C_1206_3216Metric
C7, C8: 10nF; C_0805_2012Metric
D1: SMCJ51CA; D_SMC
J1: Power header; PinHeader_1x12_P2.54mm_Vertical
J2: Signal header; PinHeader_1x06_P2.54mm_Vertical
JP1: MODE auto-retry; SolderJumper-2_P1.3mm_Open_RoundedPad1.0x1.5mm
Q1: N-ch >=80 V, Rds(on) <=15 mOhm at 10 V (DPAK); TO-252-2
Q2: BSS138; SOT-23
R1: 255k; R_0805_2012Metric
R2, R4, R6: 10k; R_0805_2012Metric
R3: 3.01k; R_0805_2012Metric
R5: 32.4k; R_0805_2012Metric
TP1: IN_PROT; TestPoint_Loop_D2.50mm_Drill1.0mm
TP2: +24V; TestPoint_Loop_D2.50mm_Drill1.0mm
TP3: +5VA; TestPoint_Loop_D2.50mm_Drill1.0mm
TP4: GND; TestPoint_Loop_D2.50mm_Drill1.0mm
TP5: FLT_N; TestPoint_Loop_D2.50mm_Drill1.0mm
TP6: IMON; TestPoint_Loop_D2.50mm_Drill1.0mm
U1: TPS26631PWP; HTSSOP-20-1EP_4.4x6.5mm_P0.65mm_EP3.4x6.5mm_Mask2.96x2.96mm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
U2: TPS7A4901DGN; MSOP-8-1EP_3x3mm_P0.65mm_EP1.68x1.88mm_ThermalVias

Connections:
+5VA: C8.1, C9.1, J2.2, R5.1, TP3.1, U2.1 (OUT)
+12V: C6.1, J2.1, U2.5 (EN), U2.8 (IN)
+24V: C4.1, C5.1, J1.9, J1.10, J1.11, J1.12, TP2.1, U1.18 (OUT), U1.19 (OUT), U1.20 (OUT)
B_GATE: Q1.1 (G), Q2.3 (D), U1.4 (B_GATE)
DRV: Q2.1 (G), U1.5 (DRV)
DVDT: C2.1, U1.10 (dVdT)
FB5: C8.2, R5.2, R6.1, U2.2 (FB)
FLT_N: J2.4, TP5.1, U1.15 (~FLT)
GND: C1.2, C2.2, C3.2, C4.2, C5.2, C6.2, C7.2, C9.2, D1.2 (A2), J1.5, J1.6, J1.7, J1.8, J2.3, J2.6, JP1.2 (B), R2.2, R3.2, R4.2, R6.2, TP4.1, U1.7 (UVLO), U1.9 (GND), U1.16 (PGTH), U1.17 (PGOOD), U1.21 (GND), U2.4 (GND), U2.9 (PAD)
ILIM: R3.1, U1.11 (ILIM)
IMON: J2.5, R4.1, TP6.1, U1.14 (IMON)
IN_PROT: C3.1, Q1.2 (D), R1.1, TP1.1, U1.1 (IN), U1.2 (IN), U1.3 (IN)
MODE: JP1.1 (A), U1.12 (MODE)
NR_SS: C7.1, U2.6 (NR/SS)
OVP: R1.2, R2.1, U1.8 (OVP)
VIN_SUPPLY: C1.1, D1.1 (A1), J1.1, J1.2, J1.3, J1.4, Q1.3 (S), Q2.2 (S), U1.6 (IN_SYS)

Notes on the sheet:
Plugs into the main board on two 2.54 mm headers. Power pins: 4 per rail, about 3 A each.
eFuse settings: OVP 31.8 V (255k/10k), current limit 6.0 A (3.01k), UVLO default 15.5 V, about 11 ms soft start at 24 V (22 nF).
MODE open = latch-off after an overload (default). Close JP to GND for auto-retry. SHDN left open (internal pull-up).
PGTH and PGOOD are tied to GND (power-good unused; TI allows PGOOD at GND). FLT and IMON go to the main board.
Reverse polarity: Q1 blocks it (TI arrangement: Q1 source to IN_SYS, drain to IN, gate to B_GATE; Q2 pulls B_GATE down).
TVS SMCJ51CA: stays off with a 48 V supply plugged in by mistake; the eFuse OVP disconnects the board.
TPS7A4901: +5VA = 1.185 V x (1 + 32.4k/10k) = 5.02 V. 10 nF on NR/SS and across the top resistor (CFF).
