LSRHokie/DIY-Flow-Bench/(commit log)

2026-06-08 BME280 initialization 0x77 and 0x76 check
    search both I2C addresses to find the sparkfun board
2026-10-28 Fix bugs found in the V2 baseline review
    - sensors.cpp: add the missing break after XGZP6899A007KPDPN in the
    reference, differential and pitot pressure conversions. The +-7 kPa
    sensor was falling through to the +-10 kPa formula.
    - sensors.cpp: BME280 start-up tries the configured address first, then
    the other standard address, and no longer freezes the controller when
    no sensor answers. The bench keeps running on the configured fixed
    temperature, humidity and baro values and reports the problem in the
    status message.
    - structs.h: add DeviceStatus.bmeAvailable for the above.
    - hardware.cpp: get5vSupplyVolts() and get3v3SupplyVolts() returned
    millivolts; they now return volts.
    -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
2026-10-28 Add V2.0 design records: overview, pin map and BOM
    - docs/V2/README.md: V2.0 goals, architecture, status and fixes so far.
    - docs/V2/pin-map.md: ESP32-S3-DevKitC-1-N32R8V GPIO map, both TCA9535
    expanders, I2C addresses, ADS1219 channels and MAF harness ID values.
    - docs/V2/bom.csv: current bill of materials, eliminated options removed.
    Claude-Session: https://claude.ai/code/session_01QEmmugJA9S77dSDSNcKrPa
2026-10-28 BOM: all parts confirmed
    Blake confirmed every part on the V2.0 BOM. Remaining prototype and
    schematic checks stay in each part's description.
    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
2026-10-28 Add ESP32-S3-DevKitC-1-N32R8V build target
    - New default PlatformIO env esp32s3-n32r8v on the pioarduino platform
    (Arduino core 3.x), with octal flash/PSRAM and a 32 MB partition table.
    - API.cpp: use the chip-independent esp_rom_crc.h instead of esp32/rom/crc.h.
    - sensors.cpp: include mafdata.h with the file's actual case (broke Linux builds).
    - docs/V2/README.md: build notes for the V2 controller.
    Compiled for the S3 with core 3.3.12: 1.24 MB program, 86 KB static RAM.
    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
2026-10-28 Separate SD bus, NO stepper alarm, dual MAF inputs, Digimatic firmware
    - microSD moves off the W5500's SPI bus to the ESP32-S3 SD host in 1-bit
    mode (GPIO41 CLK, GPIO21 CMD, GPIO3 DAT0). Pins freed by moving the bleed
    stepper alarm to expander 2 P05 and polling the W5500 (no INT line).
    - iCL42-08 alarm documented as a normally open collector: opto input wiring,
    and the fail-safe gap that comes with it.
    - MAF connector pinout with separate analog (0-5 V) and frequency pins;
    frequency input gets a pull-down and an optional open-collector pull-up.
    Bosch 0280218335 recorded as analog.
    - New firmware/digimatic-interface: ATtiny1616 Digimatic-to-I2C firmware using
    the capture method fr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
2026-10-28 Plug-in Ethernet and power modules; rev A hedges
    - W5500 chip, crystal and board RJ45 replaced by the WIZ850io module on
    two 2x6 headers.
    - TPS2663 eFuse, input TVS, bulk caps and TPS7A4901 move to a plug-in input
    power module (PM1); eFuse fault to expander 2 P07.
    - Rev A hedges: optional Digimatic level-shift footprints, solder jumpers
    (SD DAT0, MAF frequency pull-up, WIZ850io INT to expander 2 P06), test points.
    - Plan: three bench checks instead of a full prototype; PCB rev A is the prototype.
    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
2026-10-28 Add bench-check sketches for Ethernet/SD and the iCL42-08
    eth_sd_check: WIZ850io polled on SPI plus microSD on the SD host (1-bit),
    running together with a status page. stepper_check: serial-driven moves,
    enable toggle and alarm input. Both compile on core 3.3.12.
    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
2026-10-28 KiCad rev A schematics: main board and power module
    Generated by hardware/kicad/tools/design.py from the pin map and BOM:
    - flowbench-main: 6 sheets, 239 parts, 180 nets
    - flowbench-power-module: TPS26631 eFuse with reverse blocking, TPS7A4901
    Symbols converted from the KiCad library, or drawn from datasheets where the
    library lacks them. tools/verify.py rebuilds connectivity from the files and
    matches it against netlist.csv.
    Doc corrections found while drawing: ADS1219 #2 to 0x41 on the main bus
    (address clash behind the mux), 74HCT123 for the 3.3 V heartbeat, external
    reverse-polarity FETs and SMCJ51CA TVS on the power module, eFuse IMON to
    ADS1219 #2, WIZ850io headers are 1x6.
    Co-Autho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
2026-10-28 KiCad: fix off-grid pins on ADS1219 and AM26C31 symbols
    A floating-point modulo misread the symbol half-height as off-grid and
    shifted it by half a step, leaving top and bottom pins 0.635 mm off the
    1.27 mm connection grid (16 ERC warnings). verify.py now checks every pin
    and wire end against the grid.
    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
2026-10-28 KiCad: Pololu D24V22Fx pinout confirmed, corner GND and footprint
    Pin order confirmed from Pololu's labelled top view (PG, EN, VIN, GND, VOUT).
    Adds the corner GND as pin 6 and a project footprint FlowBench:Pololu_D24V22Fx
    (5 pins at 0.1 in plus the corner GND 0.4 in across), with fp-lib-table.
    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
2026-10-28 KiCad: WIZ850io as one part with a two-row footprint
    Pinout and size confirmed from the module (20 x 25 mm, two 1x6 headers).
    The two header symbols become one 12-pin WIZ850io part on footprint
    FlowBench:WIZ850io (J1 pads 1-6, J2 pads 7-12, rows 17.78 mm apart), so the
    headers can't be placed at the wrong spacing.
    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
2026-10-28 KiCad: DevKit as one part with a 25.4 mm two-row footprint
    Header pinout confirmed against Espressif's J1/J3 tables; row spacing measured
    at 25.4 mm. The two header symbols become one 44-pin ESP32-S3-DevKitC-1 part on
    footprint FlowBench:ESP32-S3-DevKitC-1 (J1 pads 1-22, J3 pads 23-44), with the
    antenna end marked. BOM notes the N32R16V as a drop-in alternative.
    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
2026-10-28 KiCad: microSD shield pin numbered SH to match the Hirose footprint
    Update PCB from Schematic reported "pad SH not in symbol" and "pad 11 not
    found": the DM3AT footprint names its shield pads SH. The symbol's shield pin
    is renumbered SH (still on GND).
    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
2026-10-28 KiCad: correct ABP2 pinout and add its DIP footprint
    The ABP2 symbol used a breakout-board pin table. Honeywell datasheet 32350268,
    Table 21, gives the sensor's I2C pinout as 1 GND, 2 VDD, 3 EOC, 4 NC, 5 SDA,
    6 SCL; the old symbol would have put 3.3 V on GND. Symbol and nets corrected.
    New footprint FlowBench:Honeywell_ABP2_DIP from Figure 13 (2.54 mm pitch,
    rows 11.00 mm, 0.73 mm holes), with the port side marked.
    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
2026-10-28 KiCad: rev A board placement script and mounting holes
    place_rev_a.py (generated by tools/placement.py) sets a 220 x 160 mm outline,
    puts the 24 V/actuator connectors on the top edge and sensor connectors on the
    bottom edge facing out, the DevKit antenna over the left edge, the RJ45 and
    ABP2 ports toward the right edge, ICs at planned spots, and packs every passive
    next to the part it serves with 1 mm clearance. Adds four M3 mounting holes
    to the schematic. placement-preview.png simulates the result.
    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
2026-10-29 KiCad: routing setup - net classes, ground plane, hole clearance, stable UUIDs
    - Net classes in the project file (Power24 2.5 mm, Stepper24 1.2 mm, Coil24,
    Supply, Rail, Field24, Default 0.25 mm) assigned by net name.
    - place_rev_a.py: 3 mm keepout around mounting holes, part values to F.Fab,
    GND plane on B.Cu with a notch and keepout under the DevKit antenna,
    WIZ850io moved up into the open space above the multiplexer.
    - Root, sheet and symbol UUIDs are now derived from the design, so
    regenerating keeps the schematic-to-PCB links.
    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
2026-10-29 KiCad: 180 x 125 mm layout, status LEDs, grouped test-point areas
    - Board shrinks from 220 x 160 to 180 x 125 mm with connectors on all four
    edges; 1.0 mm between parts kept for hand soldering.
    - 24 status LEDs: power rails, eFuse fault, stepper alarms, watchdog, armed,
    stepper power, each contactor coil, and every switch input (in series with
    its opto, no extra resistor).
    - Scattered test points replaced by grouped areas: 24 V loops, logic-supply
    loops, and controller, analog and Digimatic 2-row headers with a GND row.
    No test points on SPI/SD lines.
    - LED, test point and test header labels stay on the silkscreen.
    Claude-Ses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
